Thoma-D/UCD/README.md

**MuziSym**

Het interactieve spel dat cognitieve, sensorische en motorische elementen combineert op een muzikale, toegankelijke en gebruiksvriendelijke manier. Dit zonder begeleider en op een zelfstandige manier

Projectteam: Thoma Demets en Cieters Jeroen

2024-2025
<p align="center">
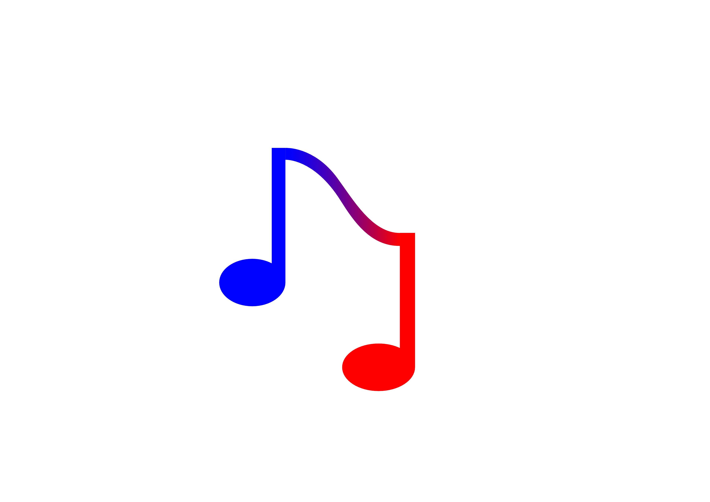
[picture p1: afbeeldingen/logo.png]


## Samenvatting
### Theoretisch
RGM: een interactieve en multisensorische oefenmethode die motorische, sensorische en cognitieve elementen bevat. Daarbij omvat:

- Het sensorische gedeelte: het waarnemen van de muziek en symbolen
- Het motorische gedeelte: het uitvoeren van de danspassen zoals in de rechterkolom
- Het cognitieve gedeelte: interpreteren van de symbolen en kleuren, deze linken aan de bijhorende danspas en deze juist coördineren.

Hierbij wordt er gebruik gemaakt van **symbolen en muziek**. Op deze muziek en symbolen worden danspassen uitgevoerd. Het combineren van deze elementen stimuleert de hersenen. 
Daarbij worden **dezelfde hersengebieden als bij het leren van een muziekinstrument geprikkeld**. “RGM therefore has the potential to activate the same brain areas as when learning how to play an instrument, although no instruments are involved.”[1]. Concreet resulteert deze methode in een hogere denksnelheid, kortere reactietijd, een betere coördinatie[2]. De theoretische werking wordt verder besproken in de inleiding.

### Spelverloop
Het initiële doel van dit spel is om de vier cilinders in de juiste volgorde te ordenen. Elk van deze cilinders wordt bij aanvang gekoppeld aan een deel (1/4de) van het gekozen muzieknummer. Bij het vastnemen van 1 cilinder begint het gekoppelde deel van de muziek te spelen en verschijnen op het schermpje de bijhorende danspassen. De mogelijke combinaties zijn in onderstaande figuur weergegeven. Nadat dit deeltje is afgespeeld, wordt een tweede cilinder vastgenomen. Het hierbij horende muziekje en danspasjes worden afgespeeld. Vanaf nu kan gekozen worden deze van plaats te verwisselen of nog een derde vast te nemen. Het spel gaat zo verder totdat de blokken in de juiste volgorde staan.
<p align="center">
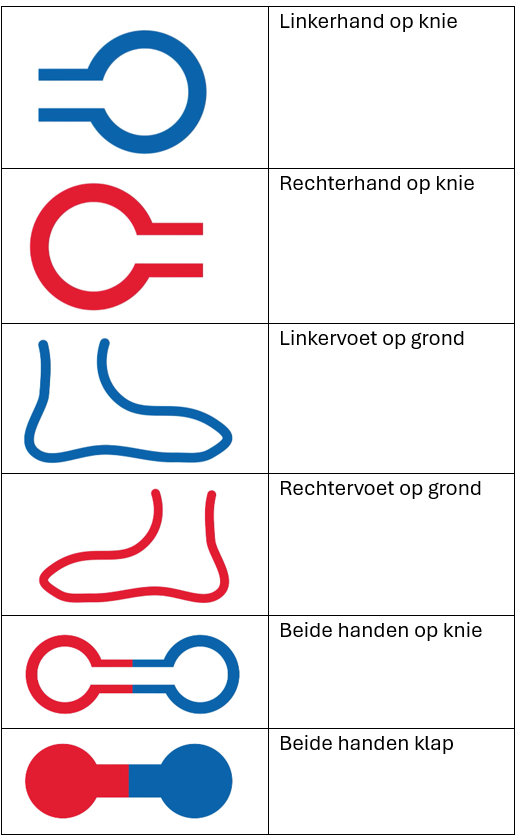
[picture p2: afbeeldingen/symbolen met uitleg.png]

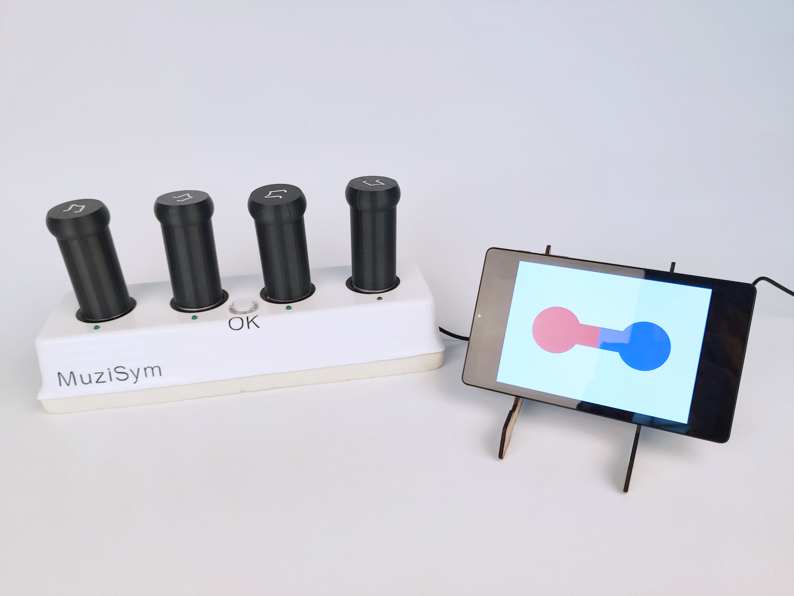
[picture p3: afbeeldingen/eind1.png]


## Introductie
### Theoretisch
Vooraleer het uitgebreider te hebben over het probleem is het eerst noodzakelijk dieper in te gaan op de theoretische werking van deze methode. Dit is noodzakelijk als achtergrond en aangezien het vervolg van dit proces steunt op dit principe.

Zoals eerder vermeld is dit een multi-sensorische denkoefening die gebruik maakt van zowel sensorische, motorische als cognitieve elementen bevat. **Het is net die combinatie van deze elementen die ervoor zorgt dat verschillende hersengebieden tegelijkertijd werken en geactiveerd worden. Het prikkelen van deze gebieden stimuleert deze hersengebieden en de verbindingen daartussen.** Daarbij is vooral het **belang van muziek niet te onderschatten.** Zo volgde uit een wetenschappelijk artikel: “In addition, musical activities induce grey and white matter changes in multiple brain regions, especially in front temporal areas”. Music also activates the dopaminergic mesolimbic system of the brain, which regulates memory, attention, executive function, mood, and motivation”[1]. Hierbij is het de bedoeling de het verkleinen van de cognitieve reserve tegen te gaan zoals uitgebreider besproken wordt in dit artikel van vrt-nws[3]

### Probleem
**Hoewel deze methode wetenschappelijk is aangetoond, staat deze methode praktisch echter nog in haar kinderschoenen.** In rusthuizen wordt slechts gebruikgemaakt van een beeldscherm [4] en [5], mensen en dan vooral ouderen thuis vallen helemaal uit de boot aangezien er in die methode een begeleider nodig is.

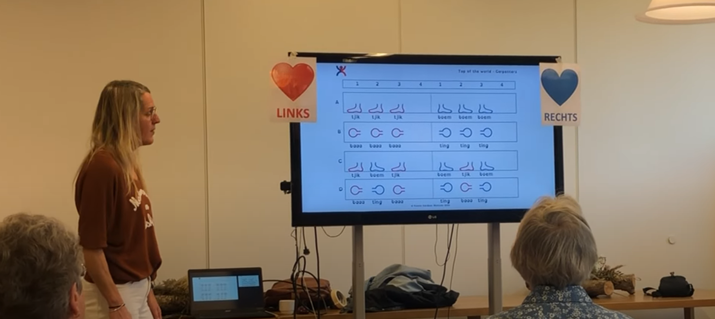
[picture p4: afbeeldingen/primitieve methode.png]


Het is deze grote “**gap**” die wij voor “65+ers zonder neurologische aandoening” op een gebruik(er)sgerichte en methodologische manier trachten op te lossen. Daarbij willen we de uitvoering van deze methode in een nieuw jasje steken zonder veel aan de theoretische werking te sleutelen.
### How might we
Hieruit volgt onze challenge, onze how might we:
**Hoe kunnen we 65 + ers zonder een neurologische aandoening preventief helpen bij het tegengaan van mentale veroudering door op een interactieve manier muziek, beweging, denken en waarnemen te integreren?**
### Stakeholders
De belangrijkste stakeholders in dit project zijn de testpersonen die de ook de eindgebruikers zijn. Wij danken hun zeer voor hun waardevolle imput. De medestudenten in de Krook voor hun andere blik en feedback op dit ontwerpproces
## Methodologie
Om een ontwerpproces tot een goed eind te brengen is het belangrijk methodologisch te werk te gaan en een goeie methodologie te gebruiken. Centraal in dit project wordtgebruik gemaakt van Zendesk triple diamond zoals in onderstaande figuur. Daarnaast wordt vanuit de piramide van Aaron Walter vertrokken. Daarbij wordt onderaan gestart om op uiteindelijk bij pleasurable uit te komen
<p align="center">
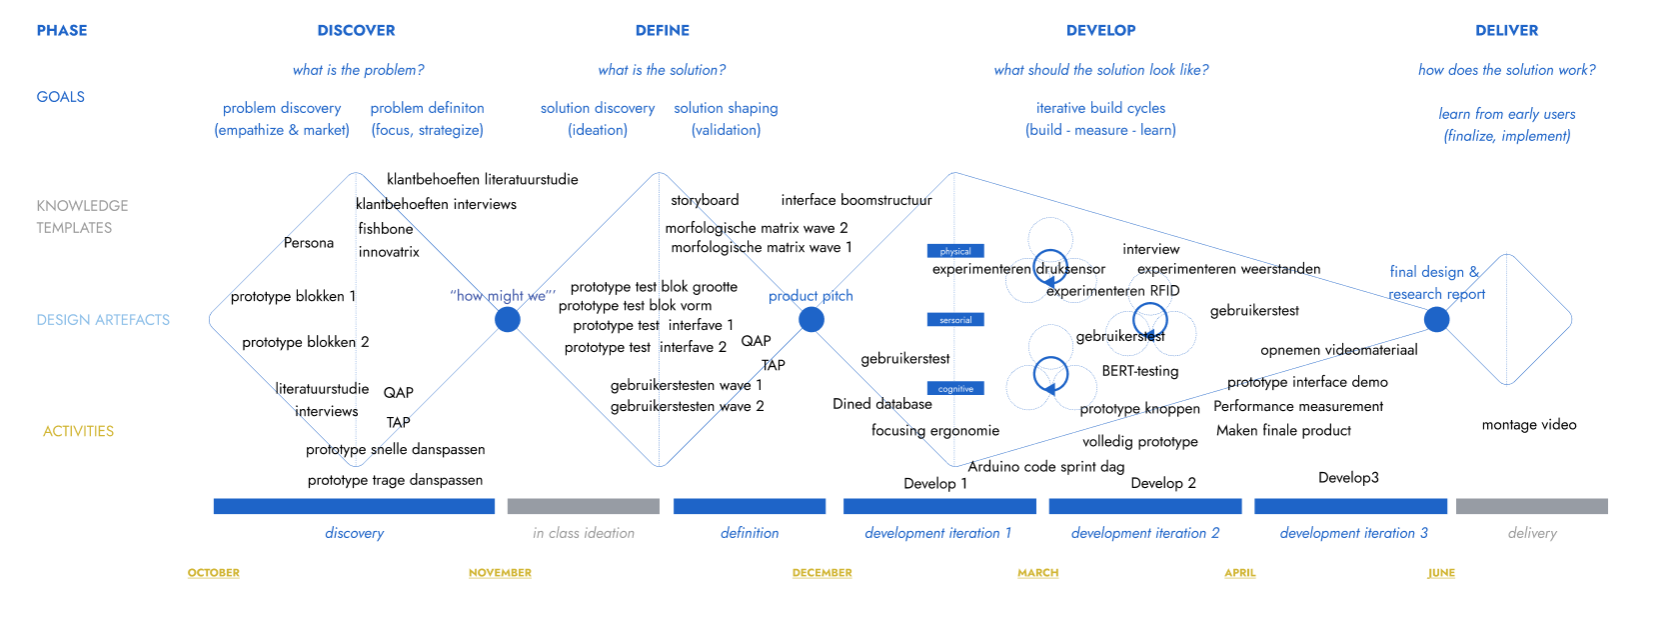
[picture p5: afbeeldingen/zendesk.png]

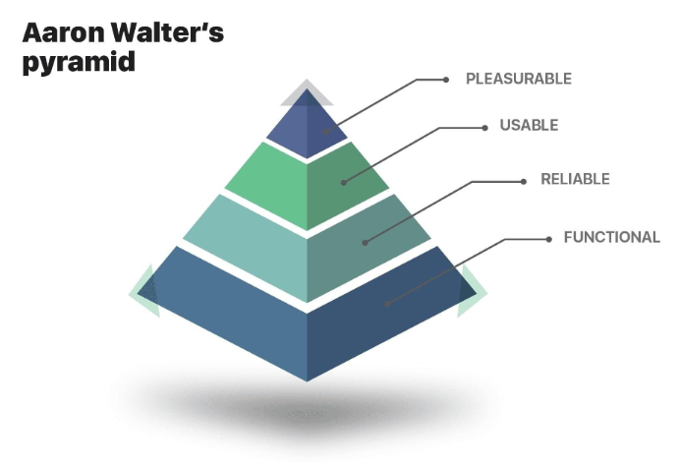
[picture p6: afbeeldingen/Aaron Walter.png]

 
### Discovery fase
Binnen deze triple diamond is de discoveryfase de eerste fase. Zoals de naam het zelf zegt is het hierbij de bedoeling een goed en volledig beeld te krijgen inzake de RGM methode. Daarbij is het belangrijkste doel om vragen als: **Waar liggen de Gaps? Hoe werkt deze methode? Wie is de geschikte doelgroep?** Te beantwoorden
Daarbij vormt de **combinatie van een literatuurstudie en interviews een goede basis**. 

### Definition fase

Binnen de definition wordt-binnen de overkoepelende Zendesk triple diamond methodologie-onze eigen methode gebruikt zoals hieronder weergegeven.
<p align="center">


Eerst wordt een storyboard opgesteld dat elke stap van het gebruiksproces benaderd. Hieruit werden mogelijke onderzoeksvragen opgesteld. Een deel van deze vragen kon al met de voorkennis van de literatuurstudie in interviews beantwoord worden. De overgebleven onderzoeksvragen onderzochten we in de gebruikerstesten. 

In deze fase wordt nu dat de fundamentele kennis er is gekeken naar de functionele parameters van het concept. Vragen als **hoeveel blokken? Welke vorm hebben de blokken? En hoe snel volgen de danspassen op elkaar?** worden beantwoord.

### Develop fase
Hierbij ligt de nadruk meer op detaillering en validering van prototypes.
In **develop 1** wordt nog gefocust op de ergonomie. 
In **develop 2** wordt nog even teruggekomen op de ergonomie. Voornamelijk wordt hierbij op de integratie van de elektronica gefocust. Hieronder vallen zowel het mechanisme van de verbinding van de cilinder met het dockingstation als het type en grootte van de knop. In **develop 3** wordt uiteindelijk het volledige spel nog eens gespeeld waarbij alle stappen nog eens gevalideerd en mogelijk verbeterd worden.

### Deliver fase 
Belangrijk: deze fase is eerder overlappend en minder chronologisch!

Uit voorgaande prototypes, gebruikerstesten, templates, experimenten (zie o.a. prototyping - elektronica) wordt een finaal prototype/product uitgewerkt. Met behulp van DaVinci Resolve en beeldmateriaal uit voorgaande testen wordt ook een video gerealiseerd. Deze geeft het ontwerpproces en het product weer.

## Discovery

#### Doelstellingen
- Formuleren van een duidelijke "How might we"-vraag om richting te geven aan het ontwerpproces
- Opstellen klantbehoeften
- Algemeen beeld inzake RGM en beantwoorden onderzoeksvragen
#### Onderzoeksvragen  
literatuurstudie
- Wat is de RGM methode?
- Secundaire onderzoeksvragen:
- Hoe helpt de RGM methode mensen? 
- Hoe werkt deze methode? 
- voor wie is deze methode het meest geschikt? 
- is de doelgroep groot? 
- Welke rol speelt muziek?  
- Hoe werkt dit in de hersenen? Welke hersengebied bevindt zich waar? 
- Hoe veroudert ons lichaam? 

interviews
- Hoe staan 65+ ers zonder neurologische aandoening tegenover de RGM-methode?
- Welke aspecten van deze methode spreken hen aan? 
- Wat zien ze liever anders?  
#### Materiaal & methoden
* Literatuurstudie 
* Interviews 
* Benchmarking

### Resultaten literatuurstudie (N=10)
- [protocol](https://github.com/Thoma-D/UCD/blob/main/Bijlages/Discovery/protocol%20literatuurstudie.pdf)
- [rapport](https://github.com/Thoma-D/UCD/blob/main/Bijlages/Discovery/literatuurstudie%20gebruiksgericht.pdf)

Om een goed beeld te vatten van de RGM-methode en alle opportuniteiten er rond, wordt begonnen met een literatuurstudie. Hierbij werden zowel wetenschappelijke artikels, websites, databases en gewone artikels bestudeerd om met een solide basis te beginnen.

**De belangrijkste bevindingen - die onder andere de onderzoeksvragen beantwoorden - worden hieronder weergegeven**:

1. Als doelgroep wordt “65+ers zonder neurologische aandoening” gekozen. Geen kinderen omdat deze methode minder efficiënt en invloed heeft op hun hersenen. 65+ers omdat dit een groot deel van de bevolking is. Zo blijkt uit Statbel dat **18,9% van de Vlamingen 65+er** is.
<p align="center">
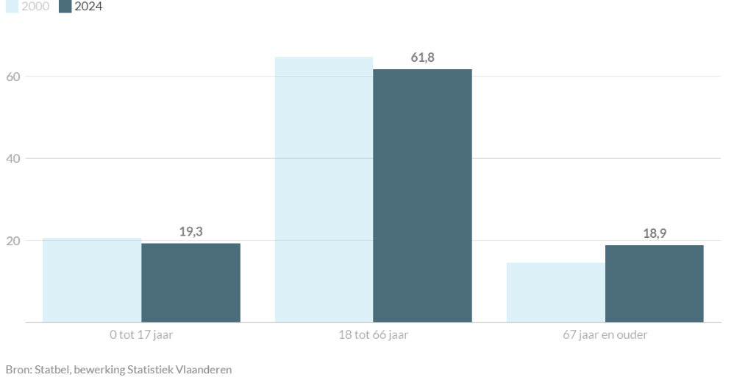
[picture p7: afbeeldingen/bevolking Vlaanderen.png]


2. De hedendaagse methode vereist een scherm, practionner en een groepsgebeuren zoals hieronder te zien. **Een belangrijke gap is dat er dus geen kant en klare thuis oplossing bestaat dat de eindgebruiker autonoom kan gebruiken.**
<p align="center">


3. **Door de sterke achterliggende theorie van RGM zoals hierboven vermeld is het nuttig de theoretische werking( combinatie muziek, symbolen en danspassen) over te nemen en in een nieuw jasje te steken. Het is de bedoeling de theoretische werking te integreren in een eindproduct.**

4. In dit [1] wetenschappelijk artikel wordt de methode theoretisch samengevat: “In addition, musical activities induce grey and white matter changes in multiple brain regions, especially in front temporal areas [3]. Music also activates the dopaminergic mesolimbic system of the brain, which regulates memory, attention, executive function, mood, and motivation.” Wat verder wordt gezegd: “RGM therefore has the potential to activate the same brain areas as when learning how to play an instrument, although no instruments are involved.” **Muziek speelt dus een heel belangrijke rol.**

5. Uit dit [6] wetenschappelijk artikel volgt dat de mens verouderd doordat dit in ons DNA zit en door chemische reacties versterkt door UV straling. In functie van deze oorzaken kan binnen onze haalbaarheid niet worden ontworpen. wel kunnen bovenstaande voordelen blijven wanneer de theoretische werking van RGM verder geintegreerd wordt tot een product.
Hieruit volgt onderstaand fishbone diagram.
<p align="center">
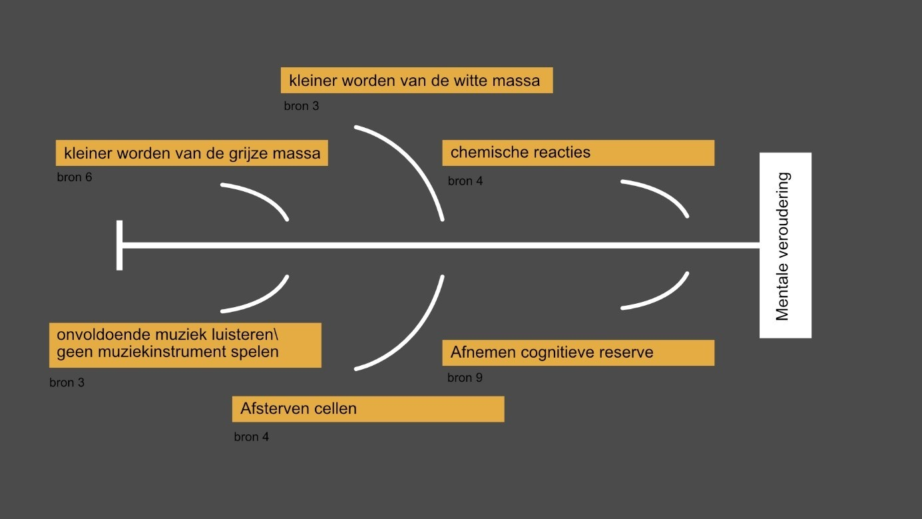
[picture p8: afbeeldingen/fishbone diagram.jpg]
 

> [!IMPORTANT]
> Design Requirements:
> - D1.1 Het product moet meerdere hersengebieden activeren	
> - D1.2 Het product moet in groep te kunnen gebruiken zijn	
> - D1.3 Het product moet fouten maken toelaten
> - D1.4 Het product moet muziek bevatten	
> - D1.5 Het product moet ritme bevatten	
> - D1.6 Het product moet de ervaring geven/ er in slagen dat de doelgroep er steeds beter in wordt

### Interviews (N=4)
- [protocol](https://github.com/Thoma-D/UCD/blob/main/Bijlages/Discovery/protocol%20interview.pdf)
- [rapport](https://github.com/Thoma-D/UCD/blob/main/Bijlages/Discovery/interview%20verslag.pdf)

Het is ook belangrijk rechtstreekse input van de gebruiker te krijgen en deze beter te leren kennen dan deze zichzelf kent. Door middel van interviews kan op deze manier direct bekeken worden wat de gebruiker zelf vindt. **Zo kan in een wetenschappelijk artikel staan dat muziek positieve effecten heeft, maar dat de gebruiker hier niet voor muziek open staat.** Om dit te vermijden werden vier proefpersonen die binnen de doelgroep “65+ers zonder neurologische aandoening” vallen geïnterviewd.

Wanneer ze gevraagd worden naar de originele methode te kijken, blijkt dat: 

1. > “Het ziet er zo moeilijk uit al deze dingen tegelijkertijd te doen”.

    Hiermee geeft Marleen Hofman aan dat ze de combinatie van motorische, sensorische en cognitieve prikkels te veel vindt." De danspassen die in de rest van dit project noodzakelijk zijn zullen dus trager op elkaar aansluiten.

2. > “Ik hoop hiermee mijn grenzen te verleggen. Achteraf hoop ik te kunnen zeggen: amai ik had nooit gedacht dat ik dit zou kunnen”.

    Hiermee geeft Joske aan wat ze met dit spel zou willen bereiken. Daaruit blijkt dat de gebruiker open staat voor het concept.

3. Als naar hun gevoelens op de **gevoelsroos van Plutchik** gevraagd wordt komen vooral de gevoelens: angst en nieuwsgierigheid op.

4. Na het afnemen van de interviews kan bovenstaande informatie samengevat worden in onderstaande persona. Dit is belangrijk in het vervolg van het proces zodat telkens gebruiksgericht ontworpen wordt.
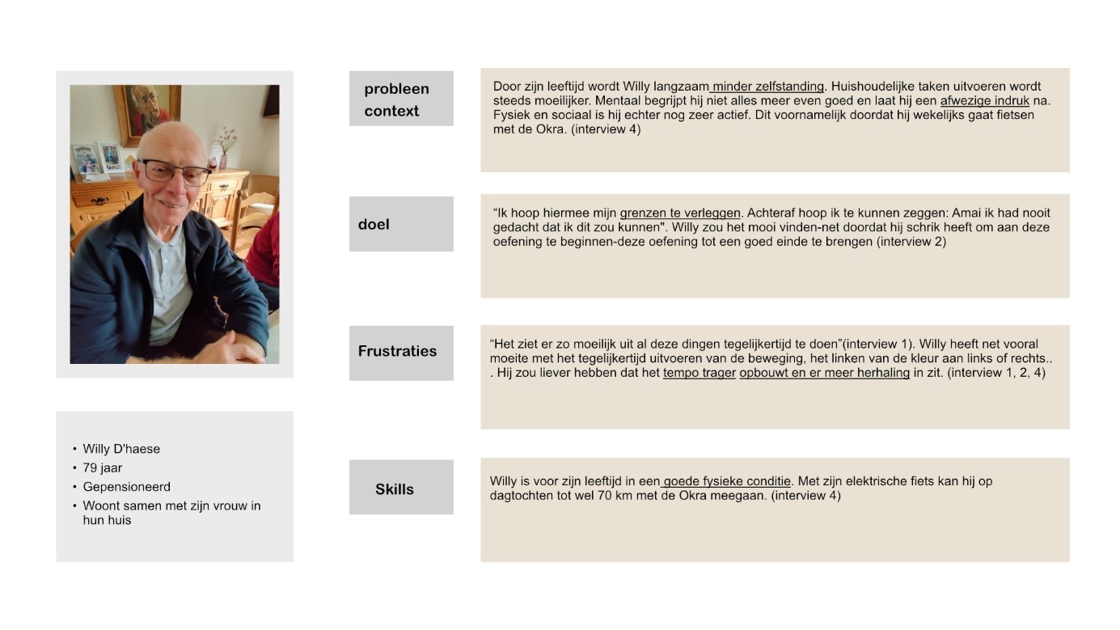
[picture p9: afbeeldingen/Persona.jpg]


> [!IMPORTANT]
> Design Requirements:
> - D1.7 Het product moet verschillende moeilijkheid niveaus bevatten	
> - D1.8 Een sessie moet geleidelijk opbouwen	
> - D1.9 De muziek moet instelbaar of gekend zijn	
> - D1.10 Het product moet thuis te gebruiken zijn	
> - D1.11 Het product moet voor zowel individuele (eenzame) als meerdere personen tegelijkertijd geschikt zijn 	
> - D1.12 Het product moet een alternatief voor dans kunnen bevatten	
> - D1.13 Het product moet buiten te gebruiken kunnen zijn 	
> - D1.14 Het product moet zo weinig mogelijk schermen, verbinding met smartphones en tablets bevatten	

### Benchmarking (N=11)
- [protocol](https://github.com/Thoma-D/UCD/blob/main/Bijlages/Discovery/ProtocoL_Benchmarking_Thoma_Demets.pdf)
- [rapport](https://github.com/Thoma-D/UCD/blob/main/Bijlages/Discovery/Studie_Benchmarking_Thoma_Demets.pdf)

Aan de hand van Benchmarking werd de huidige markt en hun huidige oplossingen geanalyseerd. Deze worden in onderstaande tabel op basis van een analyse, specificaties... weergegeven.
<p align="center">
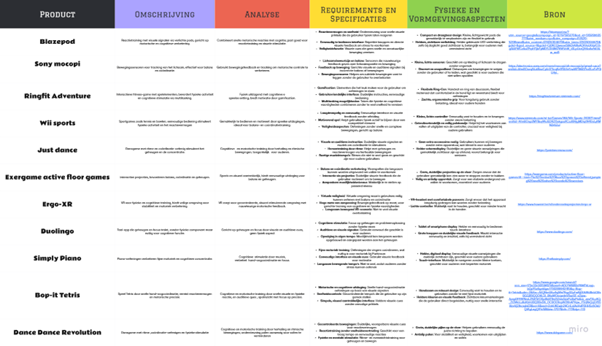
[picture p10: afbeeldingen/Benchmark analyse.png]


Momenteel passen geen producten RGM rechtstreeks toe. Daarom werden hierbij gelijkaardige, relevante en succesvolle producten geanalyseerd om zo tot extra design requirements te komen. Uiteindelijk werd met deze data volgende tabel opgesteld. 

### Conclusies & implicaties
De analyse vanuit literatuurstudie, interviews en benchmarking heeft geleid tot een duidelijk beeld van de doelgroep, “65+’ers zonder neurologische aandoening,” en hun behoeften. **De doelgroep staat open voor de RGM-methode, maar vraagt om een rustiger tempo, meer herhaling en verschillende moeilijkheidsniveaus.** Daarnaast is er een sterke voorkeur voor een gebruiksvriendelijke thuisoplossing die zelfstandig kan worden gebruikt. **Benchmarking toont aan dat er momenteel geen directe RGM-producten op de markt zijn, maar vergelijkbare oplossingen bieden waardevolle inzichten voor het ontwerp en bevestigen de bestaande marktkans.** In onderstaande innovatrix kan bovenstaande informatie nog een samengevat worden.
<p align="center">
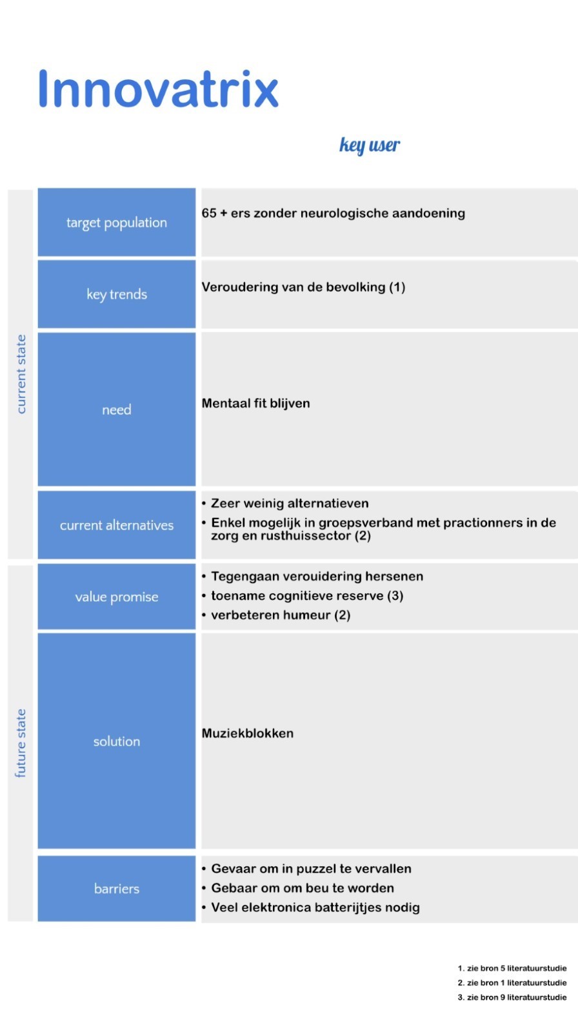
[picture p11: afbeeldingen/Innovatrix.jpg]


Uiteindelijk volgt de how might we:

**Hoe kunnen we 65 + ers zonder een neurologische aandoening preventief helpen bij het tegengaan van mentale veroudering door op een interactieve manier muziek, beweging, denken en waarnemen te integreren?**

## Definition
<p align="center">
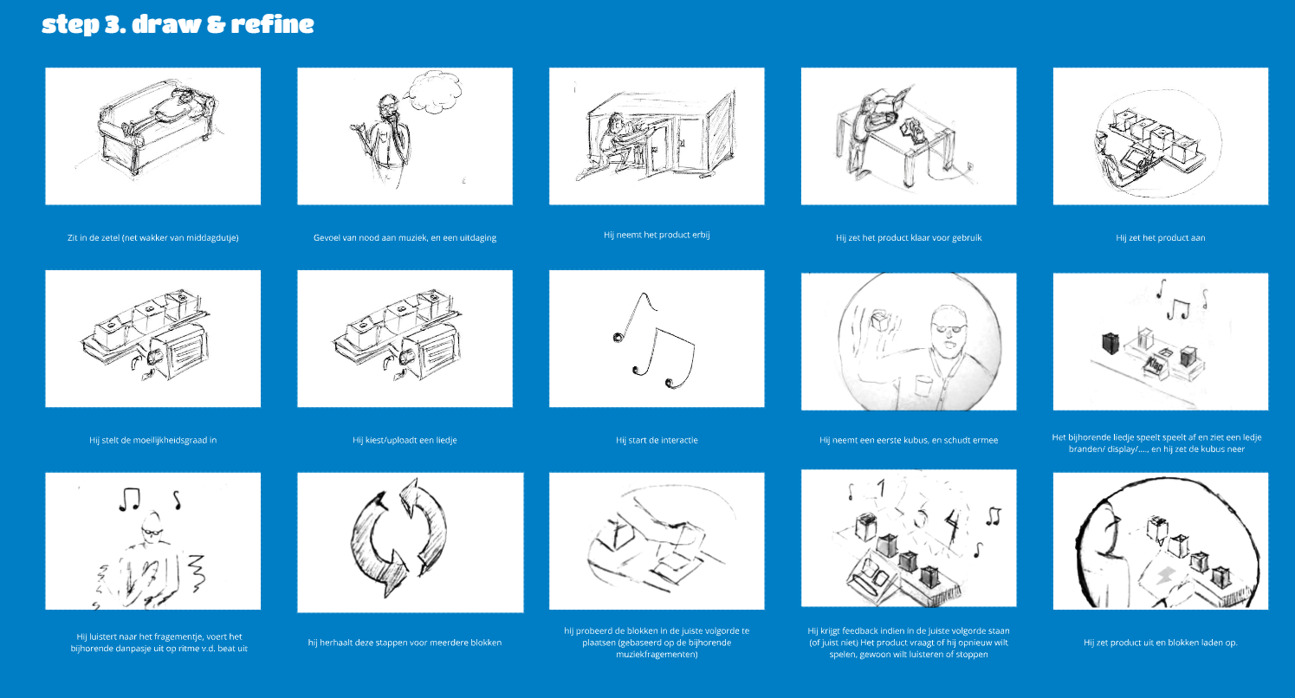
[picture p12: afbeeldingen/Storyboard.png]

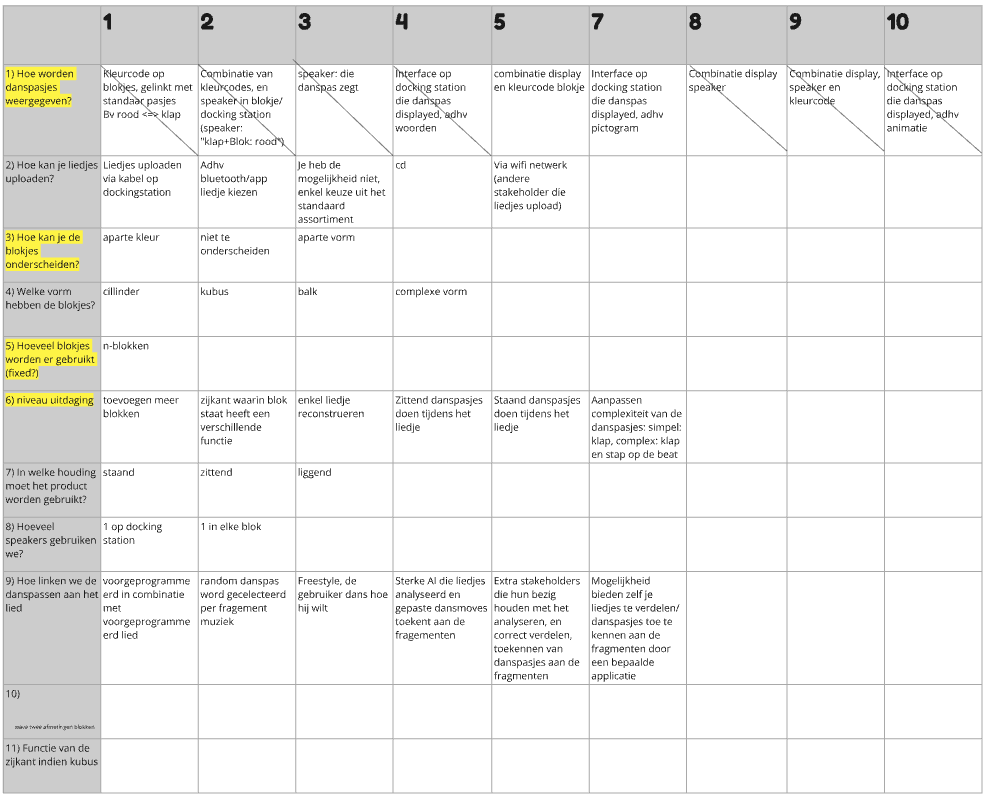
[picture p13: afbeeldingen/Wave 1 morfologische matrix.png]

</p>

In deze wave wordt vooral op de functionele aspecten gefocust. Dit a.d.h.v.de aspecten uit bovenstaand storyboard.
**Om confirmation bias te vermijden en ervoor te zorgen dat de gebruiker nuttige feedback kan geven, werd telkens van meerdere prototypes gebruik gemaakt**. Hierdoor zijn er op de afbeeldingen van prototypes meestal twee varianten te zien. 

Zoals in de methodologie beschreven werd een deel van de onderzoeksvragen al in bovenstaande matrix beantwoord. Diegene die overbleven zijn de onderzoeksvragen van deze wave. Voor de tweede wave wordt dit opniew gedaan.

### Resultaten WAVE 1 (N=5)
- [protocol](https://github.com/Thoma-D/UCD/blob/main/Bijlages/Definition/protocol%20gebruikerstest%20wave%201.pdf)
- [rapport](https://github.com/Thoma-D/UCD/blob/main/Bijlages/Definition/gebruikerstest%20wave%20one.pdf)
#### Doestellingen
- Bepalen hoe de danspassen weergeven worden
- Bepalen als de blokken te onderscheiden moeten zijn
- Bepalen van het aantal blokken
#### onderzoeksvragen
In deze fase zijn de aspecten uit het storyboard van wave 1 de onderzoeksvragen zoals:
- Hoeveel blokken worden gebruikt?
- welke vorm hebben de blokken?
- Hoe snel volgen de danspassen elkaar op
- Hoe worden de danspassen weergegeven
#### Materiaal & methoden
- Smartphone
- Video's RGM danspassen
- 6 indentiek gekleurde blokken
- 4 verschillend gekleurde blokken
- interview met:
  - TAP (think out lout protocol)
  - QAP (Question asking protocol)

<p align="center">
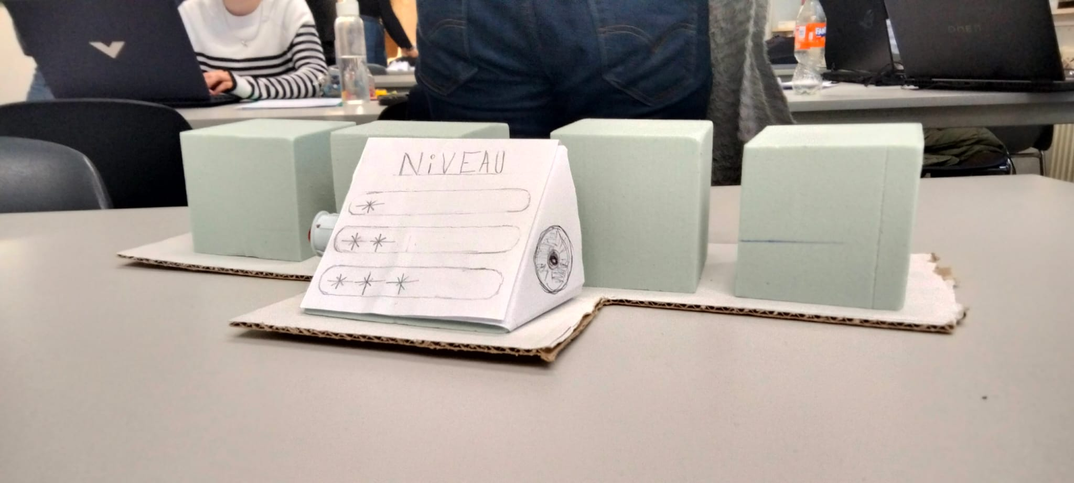
[picture p14: afbeeldingen/Prototype 1 (2).jpg]
  
</p>

#### aspect 1: Weergave danspassen 

Voor de eerste wave werden vooraf 3 variaties van videofragmenten van “Laat de zon in je hart” met RGM-symbolen voorbereid. Waarbij een verandering van danspas werd weergegeven aan de hand van een korte overgansanimatie. 

* 1: Frequentie danspassen: om de 4 slagen

  Lied verdeeld in: 4
  [Links naar video's](https://github.com/Thoma-D/UCD/blob/main/Bijlages/Definition/Videofragmenten/Traag%204/Trage%20video's)

* 2: Frequentie danspassen: om de 2 slagen

  Lied verdeeld in: 4
  [Links naar video's](https://github.com/Thoma-D/UCD/blob/main/Bijlages/Definition/Videofragmenten/snel%204/snelle%20video's%20(in%204))

* 3: Frequentie danspassen: om de 2 slagen

   Lied verdeeld in: 6
  [Links naar video's](https://github.com/Thoma-D/UCD/blob/main/Bijlages/Definition/Videofragmenten/snel%206/snelle%20video's%20(in%206))

60% van de gebruikers verkoos de trage versie. Aangezien deze cijfers verdeeld zijn, is het het best hen de keuze te geven. 

#### aspect 2: Onderscheid blokken

Om dit te testen werd eenmaal 4 blokken met dezelfde kleuren voorzien en eenmaal met verschillende kleuren.
<p align="center">
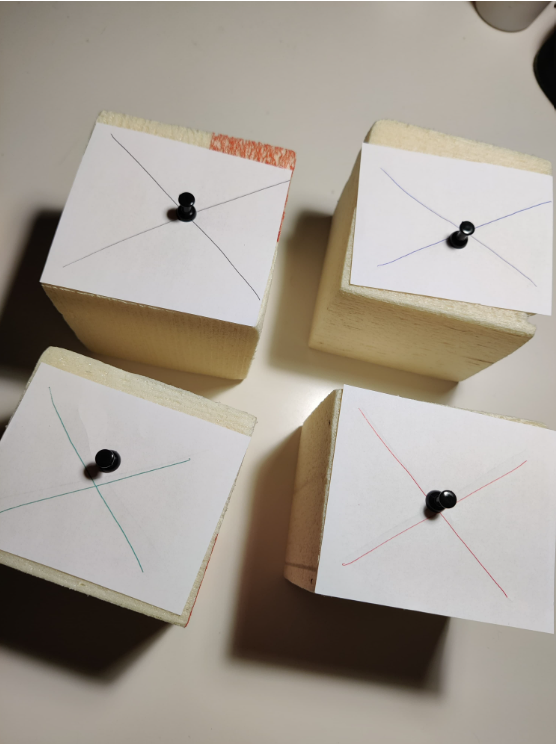
[picture p15: afbeeldingen/blokkenverschillendekleur.png]
  
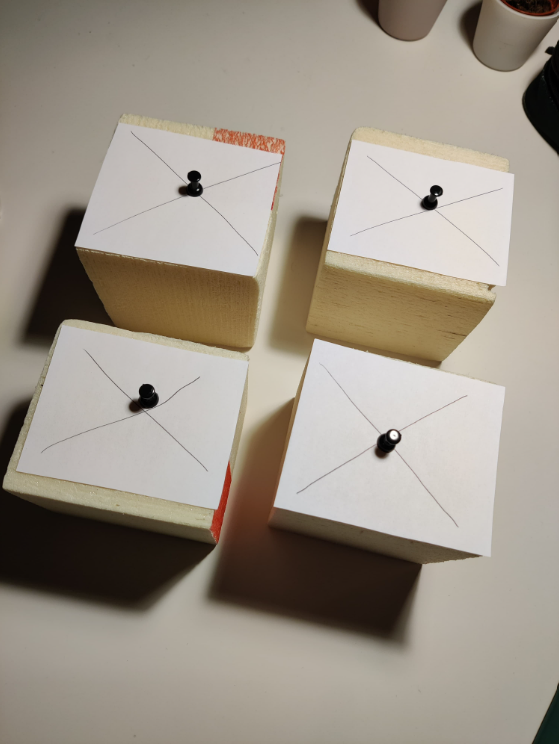
[picture p16: afbeeldingen/blokkenzelfdekleur.png]
  
</p>

Uit observatie en het QAP, konden we concluderen dat 60% (3/5) verkoos ze te kunnen onderscheiden. 

<p align="center">
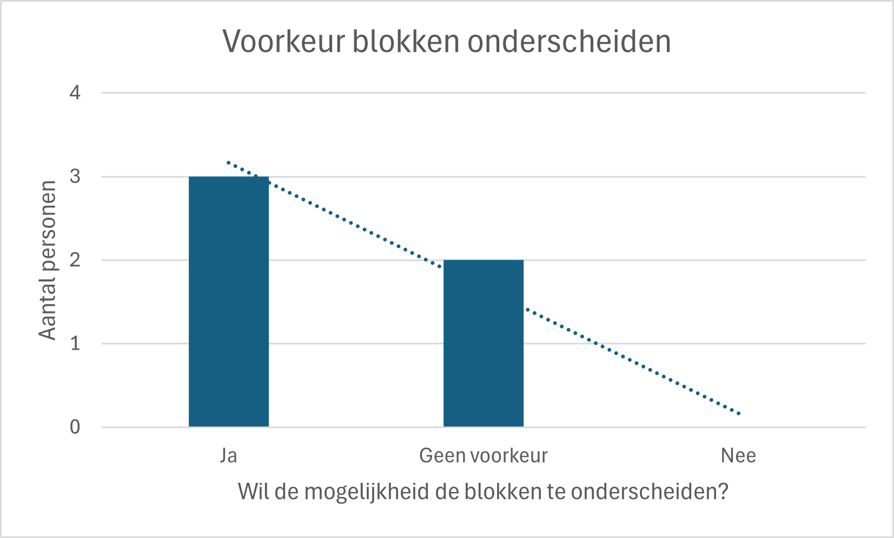
[picture p17: afbeeldingen/Grafiek Blokken onderscheiden.png]
 
 </p>

Uiteindelijk werd hieruit ook bepaald om de vorm van de blokken cilindrisch te maken om zo 2 functionele zijdes te creeren. Die nodig zijn om een kleur en effen zijde te creëren. Een cilinder is de enigste vorm die dit op een ergonomische manier toelaat. Dit leidde dan tot design requirements D2.3 en D2.2.

#### aspect 3: Aantal blokken

Na het spel met eenmaal 4 en eenmaal zes blokken gespeeld te hebben verkoos 80% de variant met 4 blokken. Ook gaf de gebruiker dit zelf aan:
> “Het is lastig om zowel op de danspassen als de muziek te letten” 

 Hieruit volgt de design requirement D.2.1

<p align="center">
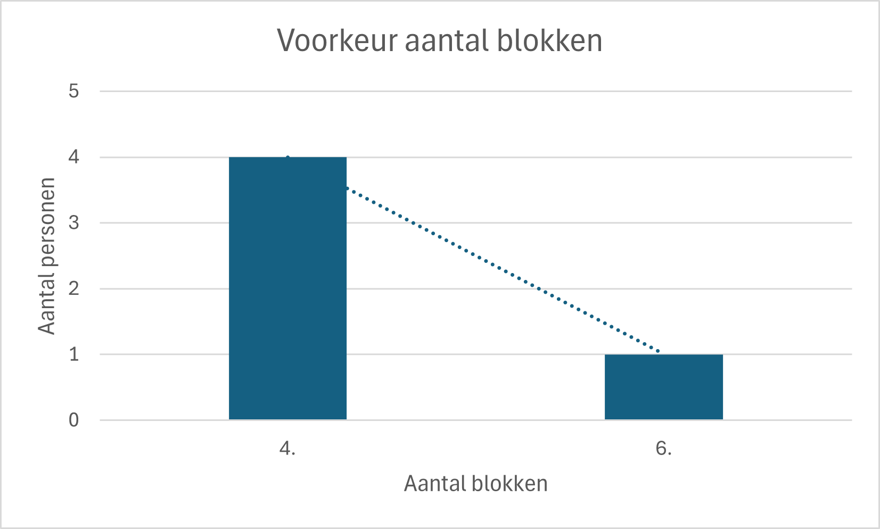
[picture p18: afbeeldingen/Grafiek aantal blokken.png]
 
 </p> 
 Wat opviel is dat de grootste moeilijk lag bij het sorteren van de blokken. 60% van de gebruikers vroeg, of vermelde dat ze graag het de mogelijkheid zouden hebben een nummer op voorhand eens te beluisteren. Vandaar design requirement D1.15. Bij de kleuren en hun bijhorende kanten werden ook veel fouten gemaakt, daaruit volgt design requirement D 4.4.
 
### Conclusies

Hieronder volgen nog enkele losstaande conclusies: 
1. Het product laat de gebruiker het liedje op voorhand horen als dit gewenst is.
2. Het product bestaat uit 4 interactieve cilindervormige blokken met 2 fuctionele zijdes.
3. Er zit 1 centrale speaker in de docking station, zo houden we de kostprijs lager en kunnen we de cilinders compacter houden.
4. De grootste moeilijkheid zit hem in het in de juiste volgorde van de cilinders plaatsen. Niet in het uitvoeren van de danspassen.
5. > “Welke kant is rood”

    De gebruiker linkt rood aan rechts. Dit doordat dit zo bij hun hoorapparaat ook zo het geval is. 

> [!IMPORTANT]
> Design Requirements:
> - D1.15 Het product moet de mogelijkheid geven het muzieknummer vooraf volledig te spelen
> - D2.1 Het product moet vier interactieve blokken bevatten	* Het product moet verschillende moeilijkheidsgraden hebben
> - D4.4 Het product moet duidelijk aangeven wat rechts(rood) en wat links(blauw) is
> - D2.3 De interactieve blokken zijn cilindervormig, om duidelijk 2 verschillende kanten te hebben, met elk zijn unieke functie
> - D2.2 	De interactieve blokken moeten zowel een te onderscheiden als een niet te onderscheiden kant hebben (1kant allemaal dezelfde kleur, 1 kant allemaal een verschillend kleur)
> - D4.3 De docking station van het product moet een speaker bevatten	

### WAVE 2 (N=5)
- [protocol](https://github.com/Thoma-D/UCD/blob/main/Bijlages/Definition/protocol%20interview%20wave%202.pdf)
- [rapport](https://github.com/Thoma-D/UCD/blob/main/Bijlages/Definition/gebruikerstest%20wave%20two.pdf)

In de tweede wave wordt meer op de details gefocust. Hieronder vallen geometrie, kleur en interface. De uitgebreide methodologie wordt onder "methodologie besproken".



### Doestellingen
- Bepalen geometrie en displaygrootte
- Bepalen interface
- Hoe staan ouderen t.o.v. belonigsystemen

### Onderzoeksvragen
In deze fase zijn de aspecten uit het storyboard van wave 1 de onderzoeksvragen zoals:
- Welke displaygrootte?
- Welke afmetingen cilinder?
- Waar moet aandacht aan worden besteed bij de interface

### Materiaal & methoden
- Figma interface met woorden en interface met symbolen
- Smartphone (6.7")
- Tablet (10.9")
- Laptop (15.6")
- tv
- Interview
- BERT-test

De gebruikerstesten worden uitgevoerd als een combinatie van BERT-testen en interviews. **De BERT-testen zorgen voor kwantitatieve informatie. De interviews voor meer kwalitatieve info.**
  
### Resultaten

#### Aspect 1: Displaygrootte

Daarvoor werden tijdens de interviews gebruik gemaakt van een smartphone, tablet, een laptop en een TV. Zoals op onderstaande figuur te zien is.  

<p align="center">
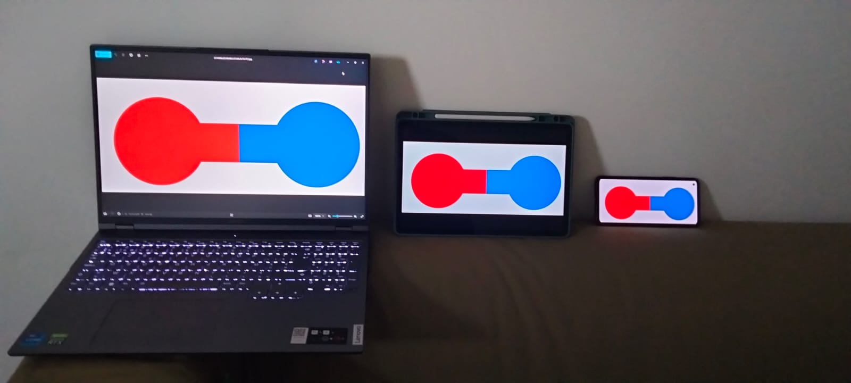
[picture p19: afbeeldingen/Schermgroottes.png.jpg]

 </p> 

Hierop reageerden de gebruikers verdeeld. 40% koos voor het 6.7" scherm, 40% tv en 20% 10.9" scherm zoals in onderstaande grafiek te zien is. Daarbij valt op dat de trendlijn daalt en links het hoogst ligt aangezien daar de meeste waarden liggen.

<p align="center">
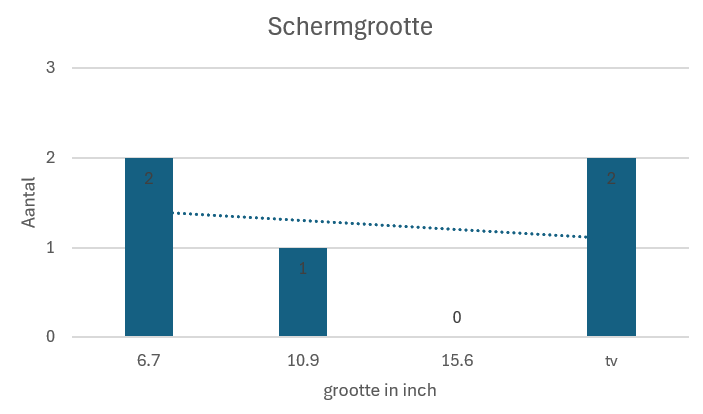
[picture p20: afbeeldingen/Schermgrootte.png]

 </p> 

Aangezien de doelgroep niet weet wat een HDMI- kabel is kan dit ook niet gekoppeld worden aan een tv-scherm. Hierdoor schieten de kleine schermen over.
>  “wat is een HDMI-kabel”.**  

#### Aspect 2: Afmetingen van de cilinders

Uit wave 1 was gebleken dat deze cilindervormig moeten zijn. A.d.h.v. drie groottes kan de gebruiker nu nauwkeuriger kiezen welke deze het meest aangenaams vindt. Uit de BERT testen en interviews blijkt dat 80% 45mm als diameter verkiest. Dit doordat deze het makkelijkst vast te pakken zijn.

<p align="center">
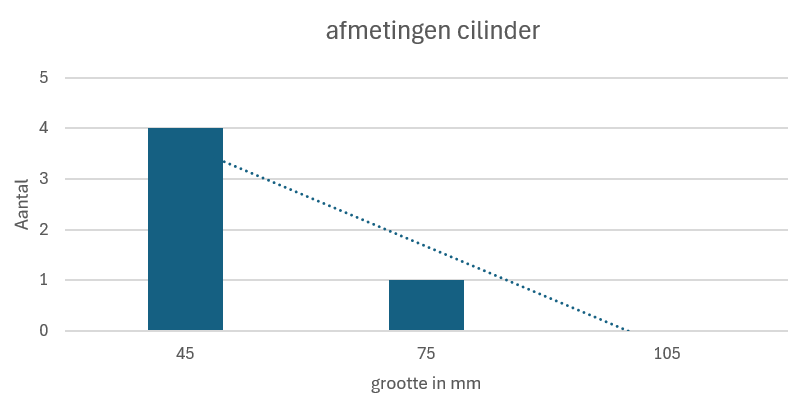
[picture p21: afbeeldingen/Afmetingen cilinder.png]

 </p> 

#### Aspect 3: Beloningssystemen

Ook binnen onze doelgroep worden de geïnterviewden wel degelijk geconfronteerd met dergelijke systemen. Vooral **klantenkaarten en klantenapps bij supermarkten blijken populair te zijn. Daarbij viel op dat hun voorkeur uitgaat naar een manuele kaart i.p.v. een app waar ze veel meer met dergelijke systemen geconfronteerd worden.** Uiteindelijk blijkt dat ze openstaan om hun vooruitgang te zien maar minder geïnteresseerd zijn in echte grote beloningssystemen. 

#### Aspect 4: Interface

Wanneer de gebruiker gevraagd wordt naar welk voorkeur de interface gaat, blijkt dat: Hoe simpeler de interface, hoe minder verwarring en vlotter de gebruiker hierdoor kan navigeren. Wat opviel, is dat de doelgroep veel **minder vertrouwt blijk te zijn met symbolen dan gewoon woorden**. Bijgevolg zal worden verder gewerkt met een interface a.d.h.v. woorden
Om de uitwerking van de interface in het vervolg van het proces vlotter te laten verlopen werd een boomdiagram van de interface gemaakt zoals in onderstaande figuur te zien is. De interfaces zijn onder "bijlagen" terug te vinden.

<p align="center">
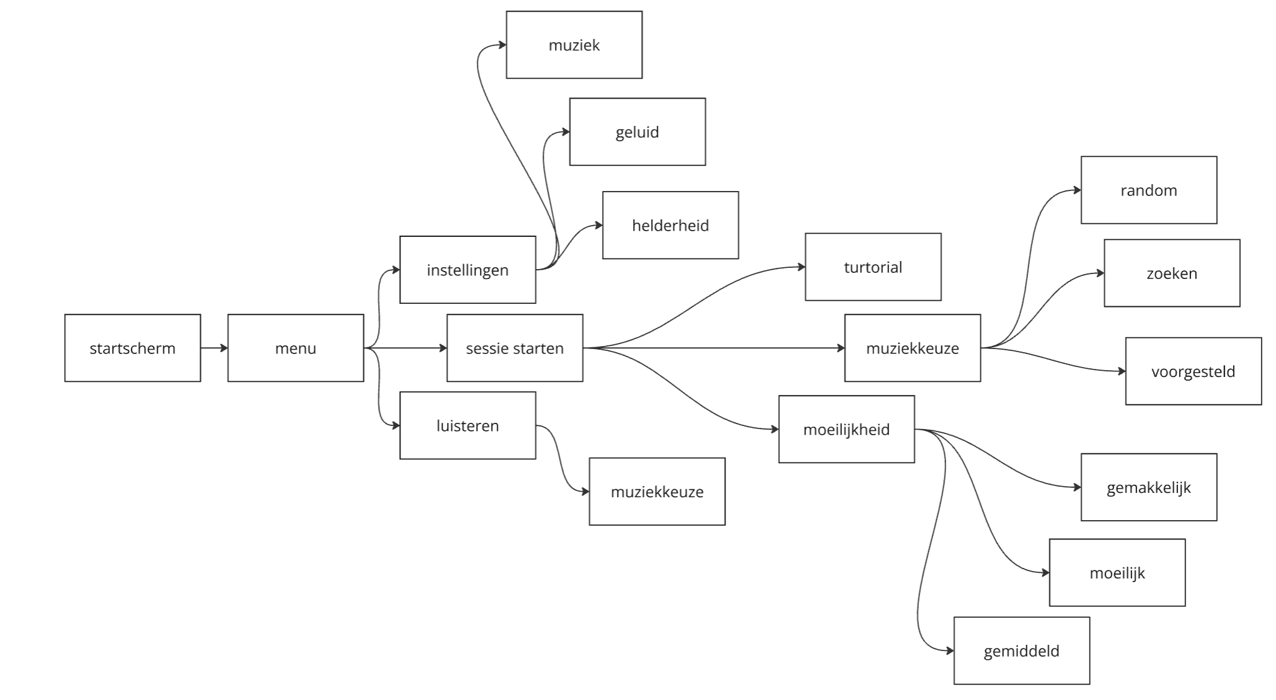
[picture p22: afbeeldingen/boomschema interface.png]

 </p>
 
### Conclusies
**Displaygrootte**

Naast het feit dat de cijfers verdeeld waren wordt voor een scherm tussen 6.7" en 10.9" gekozen. Dit om de kostprijs te drukken, om het sukkelen met HDMI poorten te vermijden (zie interview Willy: “wat is een HDMI-kabel”) en aangezien volgens de trendlijn daar de meeste waarden liggen.

**Cilindergrootte**

De cilinder heeft een diameter van 45 mm.

**Beloningsysteen**

Doelgroep wenst geen uitgebreid beloningssysteem.

**Interface**

De interface moet voldoende simpel zijn.
De interface steunt voornamelijk op woorden en niet op symbolen.

> [!IMPORTANT]
> Design Requirements:
> - D3.3 De schermgrootte ligt tussen 6.7" en 10.9"
> - D3.3 Onderstaande interface wordt gebruikt.
> - D2.4 De interactieve blokken hebben een hoogte en straal van 45mm
> - D1.17 De gebruiker heeft de mogelijkheid om zijn vooruitgang te zien
> - D3.1 en D3.2 De interface moet simpel zijn. Daarbij wordt voornamelijk van woorden gebruik gemaakt

## Develop
### Wave 1
- [protocol](https://github.com/Thoma-D/UCD/blob/main/Bijlages/Develop/develop1%20protocol.pdf)
- [rapport](https://github.com/Thoma-D/UCD/blob/main/Bijlages/Develop/develop%201%20rapport.pdf)
#### Doestellingen
1. Bepalen van de meest ergonomische massa.
 1a. a.d.h.v. gebruikerstest voor rechtstreekse input.

2. ergonomische afmetingen
  
    2a. Omtrek a.d.h.v. database gebruikt voor een grotere steekproef (werd eerder uit gebruikerstest bepaald)

    2b. Hoogte 

### Materiaal & methoden
- Ondoorzichtige cilinder (2X) 
- Anders niet tegelijkertijd 
- Weegschaal 
- Vloeistof( water) 

- Percentile driven design 
- Gebruikerstest  

- DINED-database 

#### Resultaten
**1: Meest ergonomisch gewicht**

Er werden 2 gewichten met een verschil van 100g aan de gebruiker voorgeschoteld, om deze door hen te laten vergelijken. 
Hieruit kiezen ze hun voorkeur, vervolgens wordt vanaf deze massa, met een kleiner verschil (50g, 25g) deze stap herhaald. Dit tot hun ideale massa is bepaald.

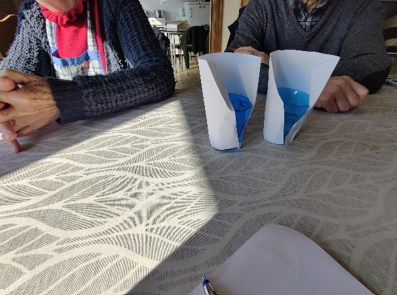
[picture p23: afbeeldingen/Gebruikerstest.png]
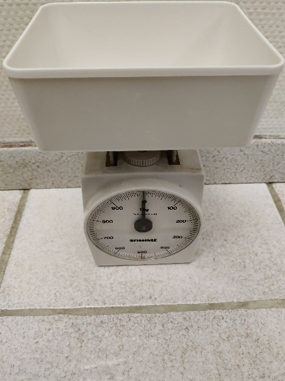
[picture p24: afbeeldingen/weegschaal.png]
 
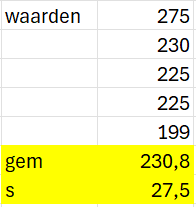
[picture p25: afbeeldingen/waarden 1A.png]



Uit deze test werden bovenstaande waarden verkregen. Binnen dit percentile driven protocol willen we een zo aangenaam mogelijk gewicht verkrijgen. Hierdoor wordt de strategie design for the mean toegepast zoals in bovenstaande staande figuur te zien is. Belangrijk is dat het gaat om het voorkeursgewicht en niet maximale. Na verwerking in excel volgt hieruit dat het gemiddelde gewicht 230,8g is.

**2a: Omtrek cilinder (database)**

Uit gebruikerstesten blijkt dat de gebruiker de cilinder op twee verschillende manieren vastneemt zoals hier onder te zien.

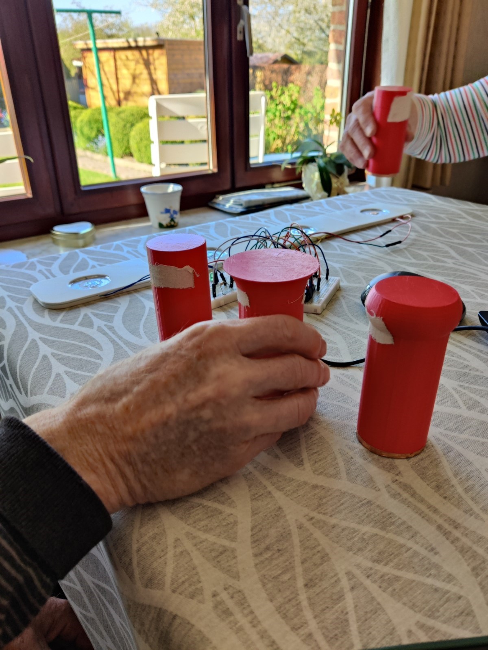
[picture p26: afbeeldingen/Gebruikerstest_Dev2_Grip1.jpg]

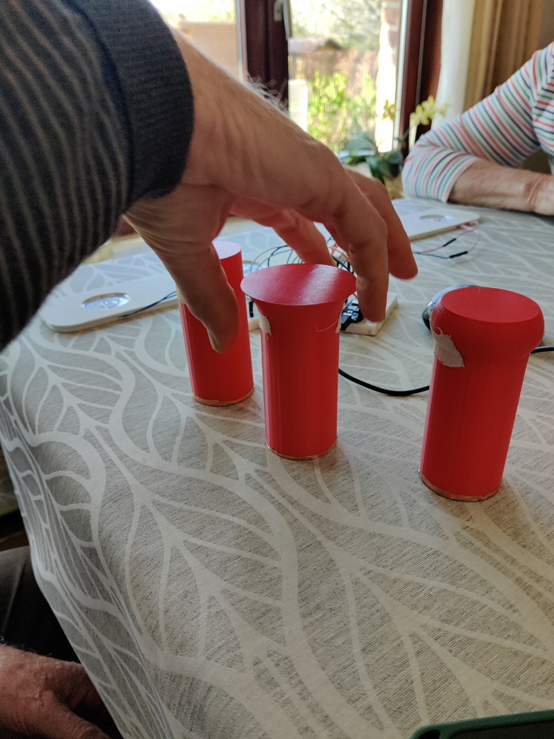
[picture p27: afbeeldingen/Gebruikerstest_Dev2_Grip2.jpg]


 één daarvan is met de volledige hand. Om dit te onderzoeken werden in de Dined database onderstaande parameters ingesteld. Hierbij zijn de grote waarden interessant. Aangezien een maximaal contactopp belangrijk is. Dus de omtrek is 129mm + 3*13=155mm. Hieruit volgt ideale diameter = 49,34mm. Belangrijk om te vermelden: deze gegevens zijn van leeftijden van 20-30j aangezien de leeftijden van 60+ers niet bekend is.
<p align="center">

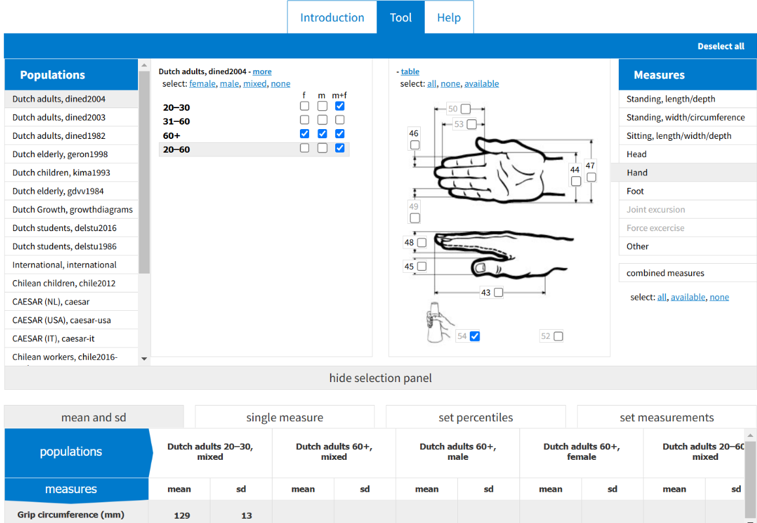
[picture p28: afbeeldingen/data 2A.png]
 

.

**2b: hoogte cilinder (database)**

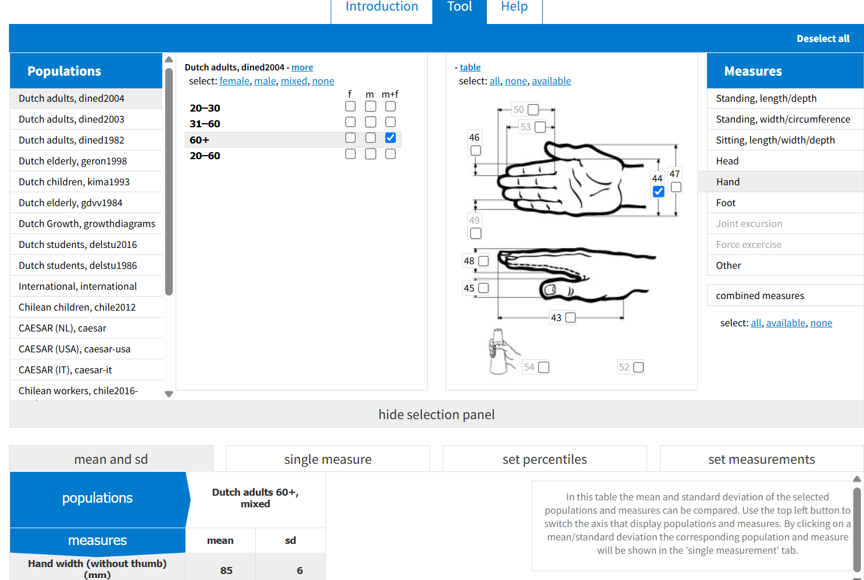
[picture p29: afbeeldingen/data 2B.png]


De database werd ingesteld zoals hierboven weergegeven. Aangezien hier de grootste handen de cilinder ook moeten kunnen vastnemen wordt weer design for the tall gebruikt. waarde = mean + 3 sd = 85+3*6=103mm

### Conclusies
**1: Meest ergonomisch gewicht**

De cilinders hebben elk een gewicht van 230,8g. 

**2a: Omtrek cilinder (database)**

Wanneer de waarden van de omtrek van de cilinders uit de database en de gebruikerstest vergeleken worden valt op dat deze vrij dicht bij elkaar liggen. Respectievelijk 49,34 mm en 45mm. Aangezien de gebruikers zelf voorhang hebben op databases wordt verder gerekend met 45mm

**2b: hoogte cilinder (database)**

De hoogte van de cilinder bedraagt 103mm.

> [!IMPORTANT]
> Design Requirements:
> - D2.6 De cilinder weegt 230,8g
> - D2.5 De hoogte bedraagt 103mm
### Wave 2 (N=4)
- [protocol](https://github.com/Thoma-D/UCD/blob/main/Bijlages/Develop/develop%202%20protocol.pdf)
- [rapport](https://github.com/Thoma-D/UCD/blob/main/Bijlages/Develop/develop%202%20rapport.pdf)
#### Doestellingen
1. Bepalen welke grip
2. communiceren dat cilinders goed contact hebben

    2a. Bepalen begrip contact LED's

    2b. vorm cutout

    2c. Keuze knop

3. keuze knop
#### Materiaal & methoden
- Knoppen
- extra scherm(protopie)
- Prototype docking station+ arduino/ bekabeling
- Cilinders (+weerstanden) 
-TAP & QAP
- **Bipolar emotional response testing (BERT)**
- **comparative usability testing**
#### Resultaten
#### 1. Cilinder-grip
<p align="center">


 </p>
Hiervoor werden 3 cilinder toppen met elkaar vergeleken in spel context en achteraf geevalueerd op meerdere categorieën met een comparative usability testing. De gebruiker werd gevraagd een score op 5 te geven op vlak van esthetiek en 5 op functionaliteit.
<p align="center">
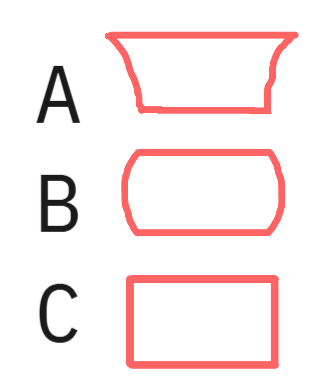
[picture p30: afbeeldingen/CilinderGripSoorten.png]

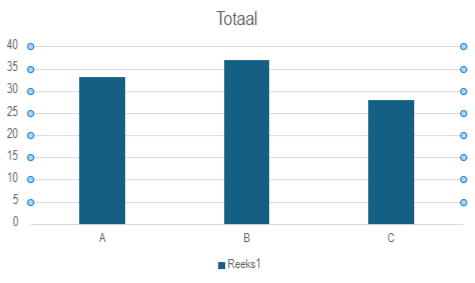
[picture p31: afbeeldingen/Gebruikerstest_Dev2_Totaal.jpg]

</p>

Uit deze test blijkt dat deze grip B door de meeste gebruikers gekozen wordt. Vervolgens grip A en als laatste C. 
> [!IMPORTANT]
> Design Requirements:
> - D2.7 B wordt gebruikt als grip

**2. communiceren dat de cilinders zeker een goed contact hebben**

Hiervoor werd onderstaand prototype gebouwd.
<p align="center">
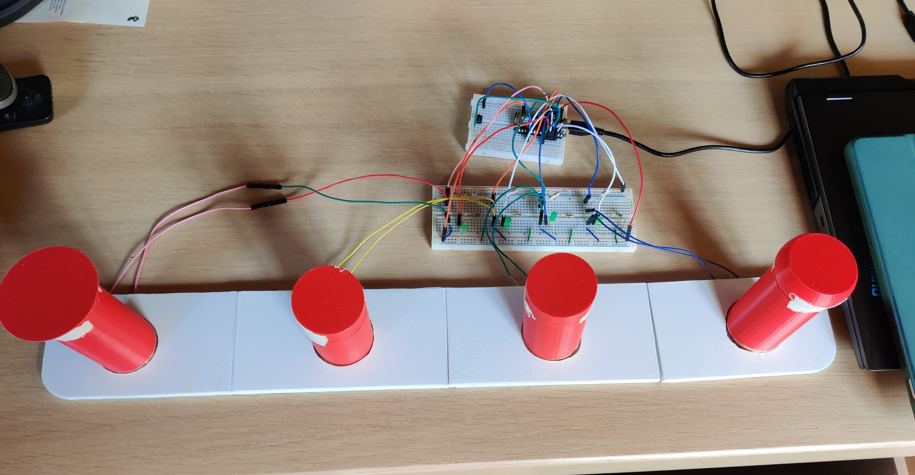
[picture p32: afbeeldingen/prototype.jpg]


#### 2a. vorm cutout
Om te zorgen dat de elektronische elementen correct worden gealinieerd worden inzinkingen voorzien waarin de cilinders inpassen. Deze affordance maakt ook duidelijk waar de cilinders moeten worden geplaatst op de docking station.
<p align="center">
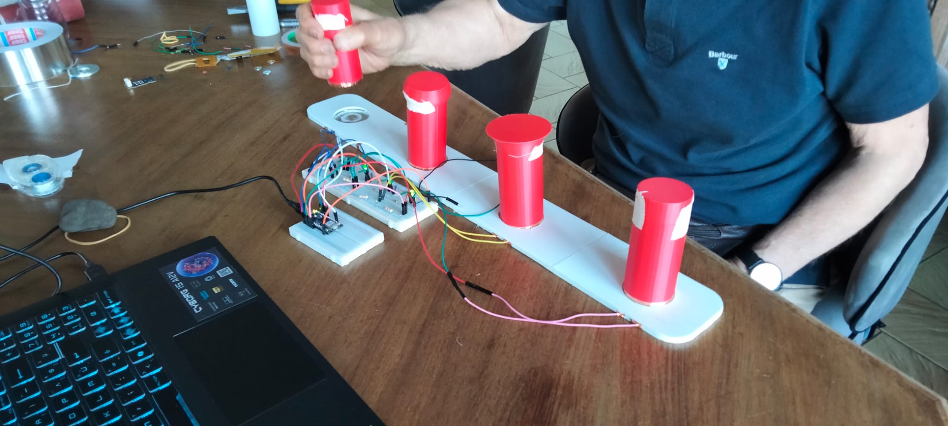
[picture p33: afbeeldingen/Gebruikertest_DEV2_GRIP2.jpg]

</p>
Tijdens de observatities werd vastgesteld dat deze hielpen bij het terugplaatsen van de cilinders.

Hieruit volgt D
#### 2b. LED's
 Er werd gestest in spel context of een LED die brand wanneer de cilinders een goed contact hebben een meerwaarde geven.
<p align="center">
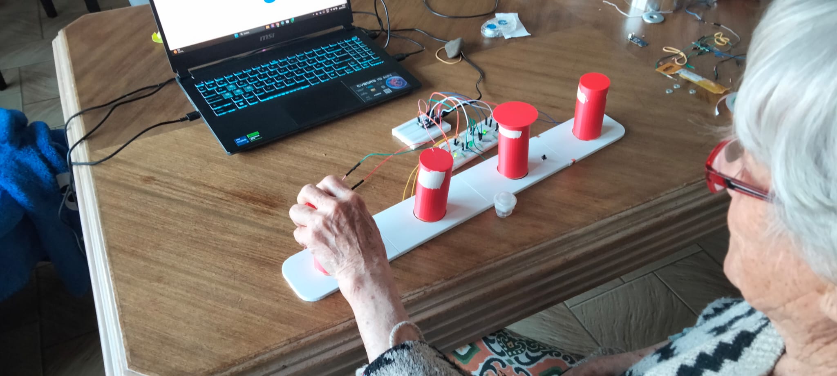
[picture p34: afbeeldingen/Gebruikertest_DEV2_GRIP.jpg]

</p>

#### 2c. Keuze knop
Hierbij werden meerdere knoppen en touchscreen opties met elkaar vergeleken adhv BERT testing.
<p align="center">
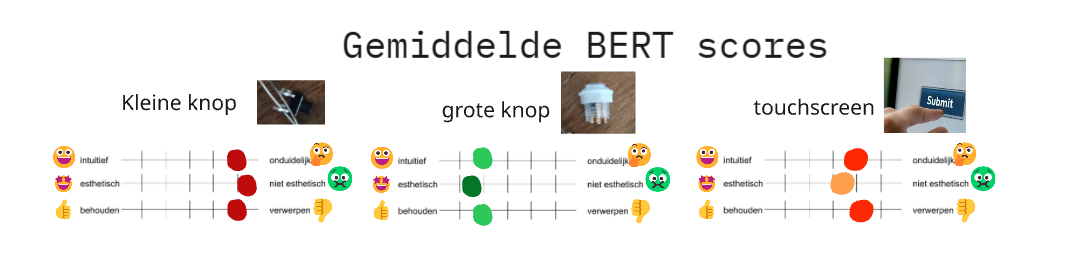
[picture p35: afbeeldingen/Gemiddelde BERT scores.png]

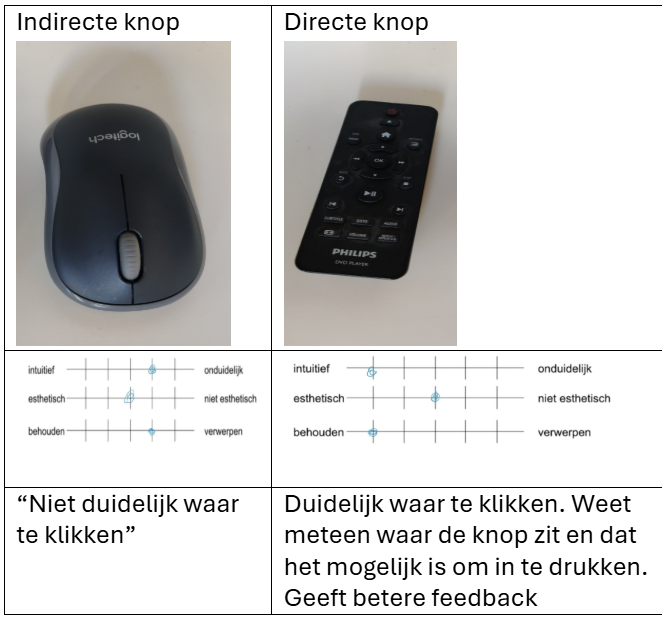
[picture p36: afbeeldingen/knop direct-indirect.png]


Hieruit volgt dat de gebruiker de "grote en directe" arcade knop verkiest.

> [!IMPORTANT]
> Design Requirements:
> - D2.7 De cilinders hebben grip B 
> - D4.5 De knop heeft een minimale diameter van 19mm
> - D4.6 De knop is een directe drukknop 
> - D4.7 De dockingstation bevat cutout's van de cilinders als affordance
> - D4.8 De dockingstation bevat LED's die aangeven wanneer de cilinders een goed contact maakt.
> - D4.9 De dockingstation bevat een arcade knop voor een spel te beëindigen

### Wave 3
- [protocol](https://github.com/Thoma-D/UCD/blob/main/Bijlages/Develop/develop%203%20protocol.pdf)
- [rapport](https://github.com/Thoma-D/UCD/blob/main/Bijlages/Develop/develop%203%20rapport.pdf)

#### Doestellingen

Interactie en fasen van het spel evalueren.

#### Materiaal & methoden
- Storyboard
- Camera
- extra scherm (protopie)
- Prototype docking station (+laptop))
- Cilinders (+weerstanden) 
- **performance measurement**
#### Resultaten

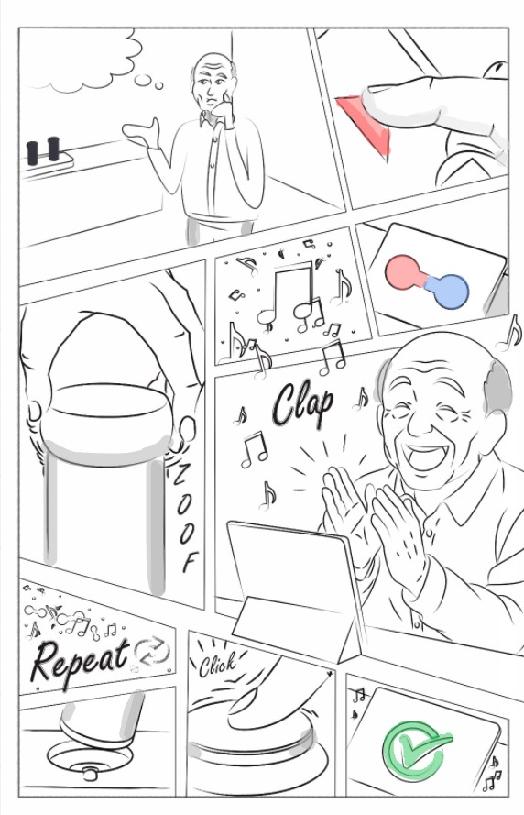
[picture p37: afbeeldingen/Storyboard_Kleur.jpg]


|

Uit bovenstaande storyboard werd de onderstaande tabel opgesteld voor het uitvoeren van een performance measurement.

|

| Nr. | Taak | Omschrijving | Moeilijk/makkelijk | Opmerking |
|-----|---|---|---|---|
| 1 | Aanzetten prototype | Gebruiker drukt op ronde knop in het midden. | | |
| 2 | Positioneren cilinders| Gebruiker zet de cilinders in willekeurige volgorde op het spelbord | | |
| 3 | Doorlopen demo | De gebruiker doorloopt a.d.h.v. het scherm de demo | | |
| 4 | Starten spel | De gebruiker drukt op ronde knop in het midden | | |
| 5 | Nemen cilinder | De gebruiker weet dat deze een cilinder moet nemen | | |
| 6 | Uitvoeren danspassen  | De gebruiker weet dat deze na het nemen van een cilinder de danspassen moet uitvoeren | | |
| 7 | Nemen tweede cilinder | De gebruiker weet dat deze een tweede cilinder moet nemen | | |
| 8 | Terugplaatsen | De gebruiker weet dat de cilinders in een andere volgorde kunnen worden terug geplaatst | | |
| 9 | Controleren | De gebruiker weet dat de middelste knop dient om te valideren | | |
| 10  | Uitzetten | De gebruiker kan het spel uitzetten door uit het stopcontact te trekken | | |

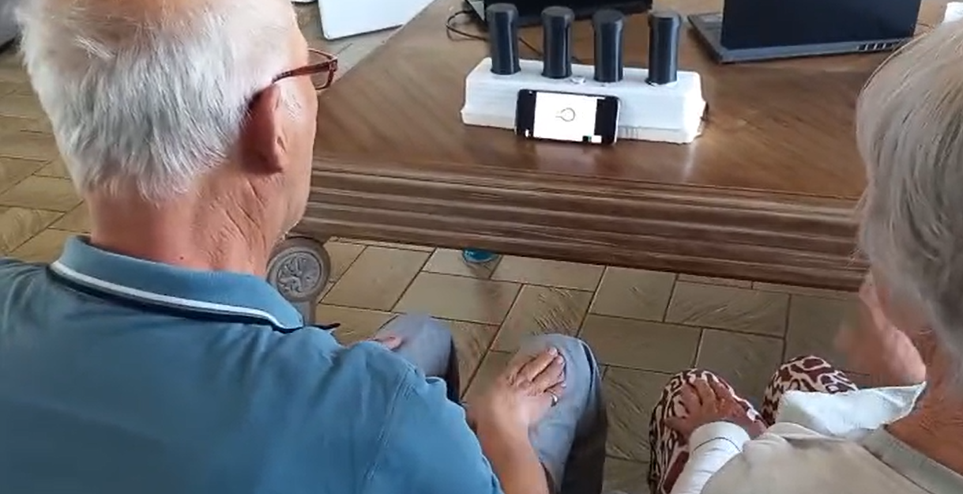
[picture p38: afbeeldingen/DEV_3_Test.png]


Hieruit volgende volgden dat 11/40 taken moeilijk verliepen, ookwel 27.5%. waarbij 75% moeite had met taken 2 en 3 en 50% met taken 4 en 6.

Uiteindelijk werden volgende oplossingen geimplementeerd voor de taken die moeilijk verliepen:

| Taak | Oplossing |
|---|---|
| 3 & 4 | Icoontje met “ok” toevoegen |
| 2  | Toevoegen folie |
|  2 | Cirkels rond knop en cilinders toevoegen |
| 3 & 4 | Extra scherm toevoegen met “druk om te starten” |
|6| uitleg ivm symbolen|

## Prototyping
### keuze elektronica
Een van de laatste zaken die moet bepaald worden is de keuze van de electronica. Daarvoor werd gestart vanuit een keuzematrix waarin de relavante mogelijkheden stonden. Deze matrix is hieronder weergegeven.
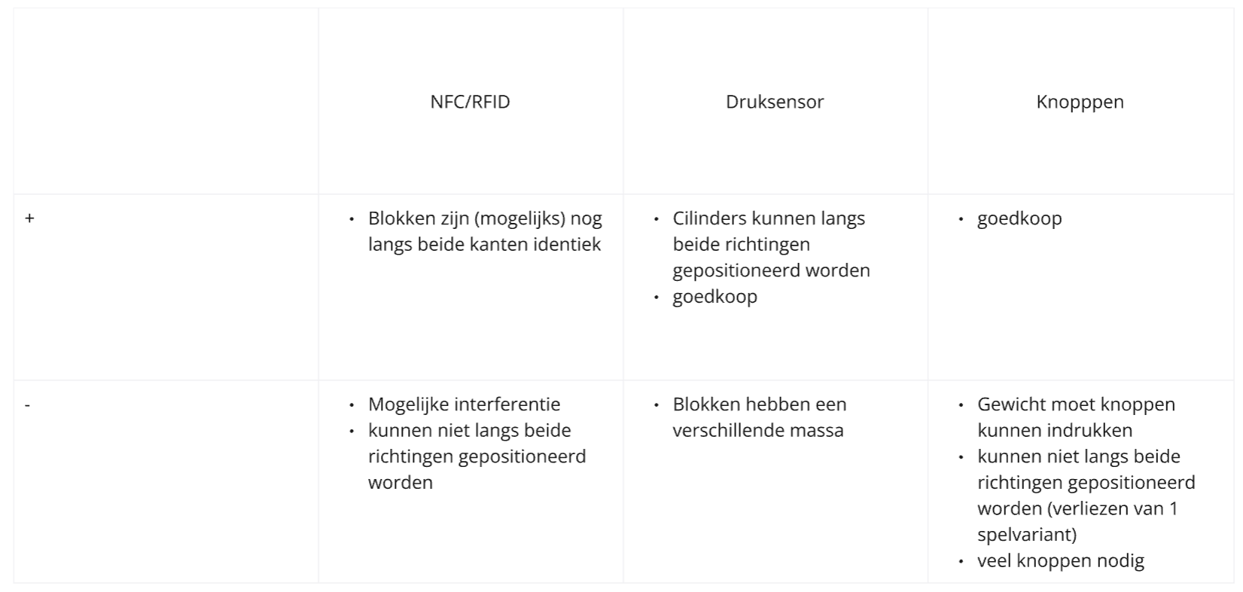
[picture p39: afbeeldingen/keuzematrix elektronica.png]


#### Druksensoren
Uit deze matrix blijken de druksensoren het interessantst te zijn. Dit vooral aangezien deze optie de enigste mogelijkheid biedt het spel ook met de cilinders omgedraaid te kunnen spelen. Helaas blijkt deze methode onnauwkeurig te zijn. Hierbij werd getest met vier DF9-40series druksensoren met een bereik van 20g - 2kg volgens onderstaande opstelling met spanningsdeler. De code hiervan is terug te vinden onder de map "code".
<p align="center">
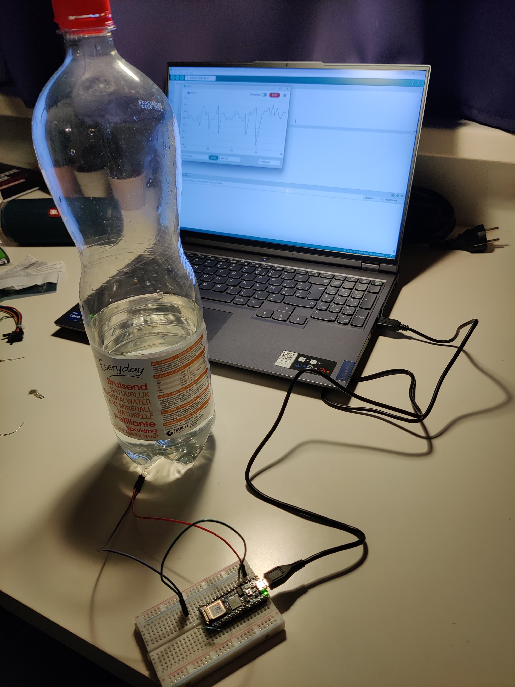
[picture p40: afbeeldingen/druksensor1.jpg]

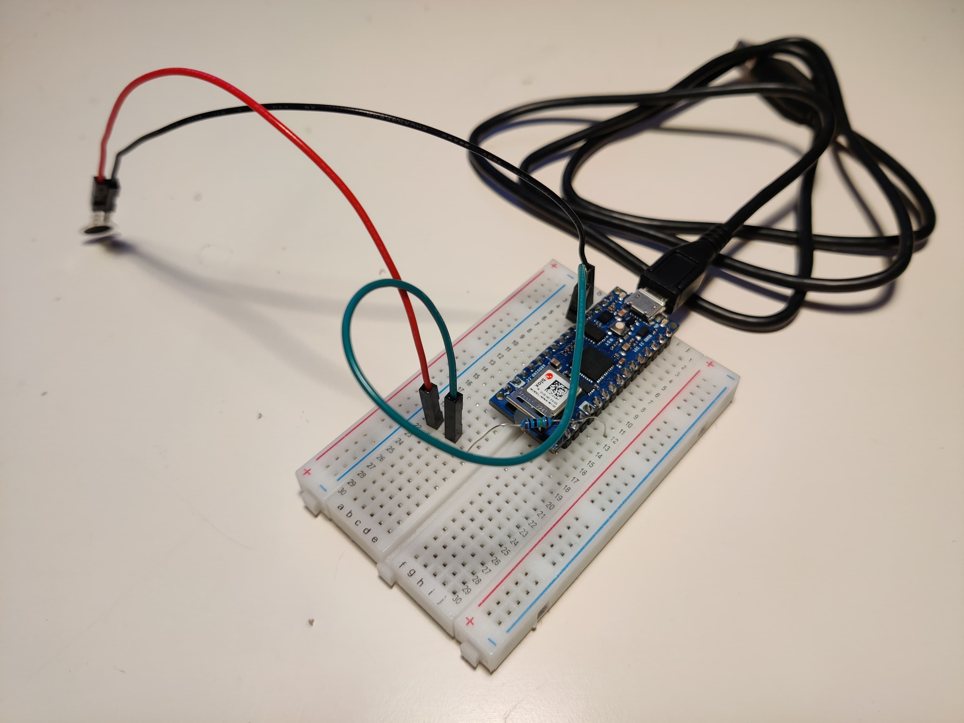
[picture p41: afbeeldingen/opstelling druksensor.jpg]

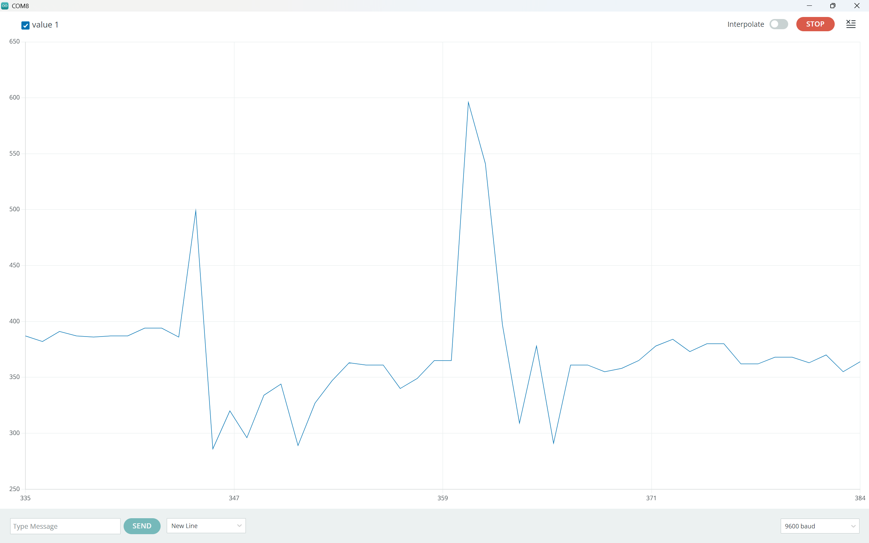
[picture p42: afbeeldingen/ruis_druk.png]

 </p>

>Praktische voordelen en uitdagingen druksensoren:
> - Goed in detecteren als er iets of niets opstaat
> - moeilijk te calibreren bij een constante indrukking
> - slechte gevoeligheid: Op huid heel gevoelig, op papier en andere materialen detecteert pas bij grote massa
#### RFID/NFC lezers
Om deze reden werd gekozen om vervolgens verder te werken met de RFID/NFC lezer. 

Uit onze testen hiermee bleek dat er **geen interferentie optrad tussen de tags**. Echter is het heel complex en ingewikkeld om vier lezers aan 1 arduino aan te sluiten. Voor 1 lezer blijken ook 7 aansluitingen nodig te zijn. Door het gebruik van 1 lezer zou er te veel aan gebruiksvriendelijkheid moeten worden ingeboet. De gebruiker zou op een bijkomstige manier de positie van de cilinder moeten ingeven. 
<p align="center">
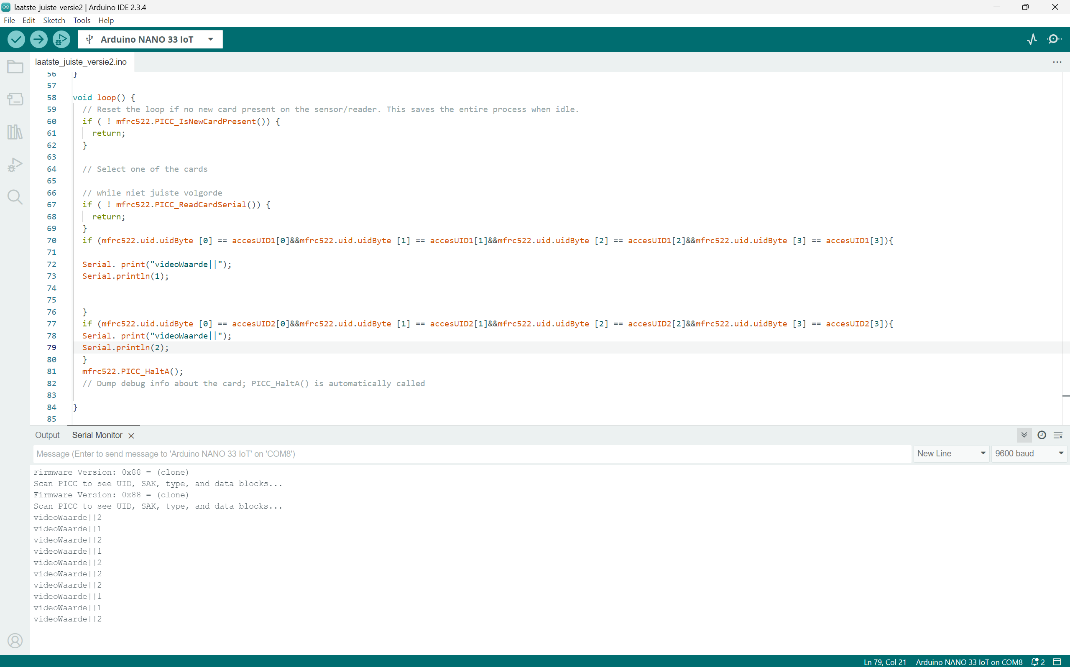
[picture p43: afbeeldingen/nfc output2.png]

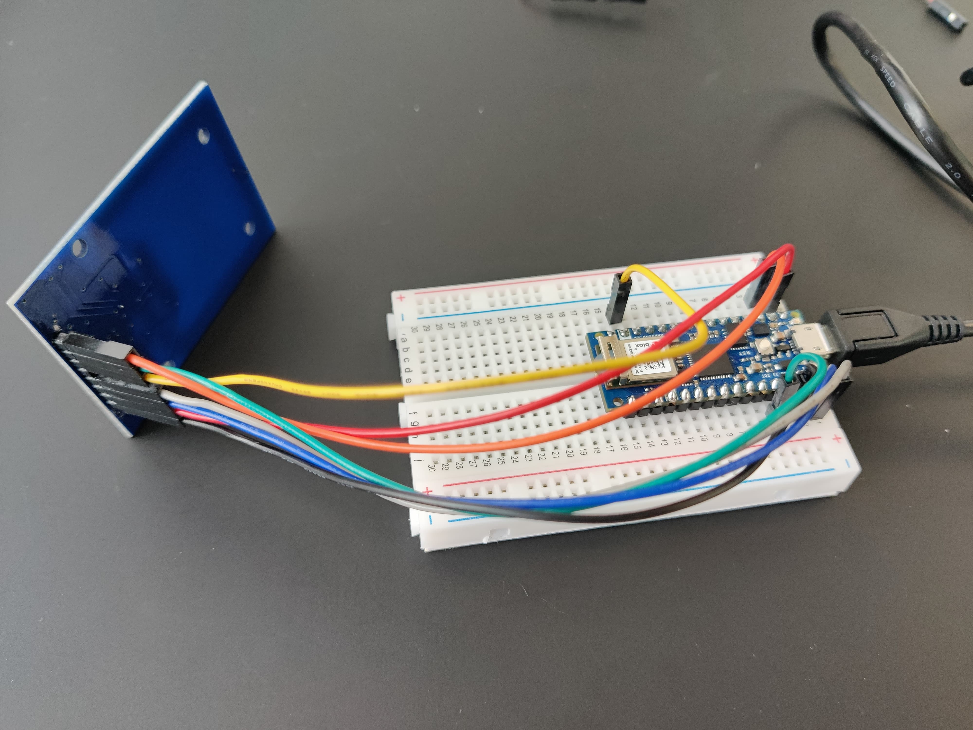
[picture p44: afbeeldingen/opstelling rfid.jpg]

</p>

>Praktische voordelen en uitdagingen RFID/NFC lezers
> - geen interferentie tussen naburige tags dus betrouwbaar
> - gebruik vier lezers nodig, lastig voor 1 enkele arduino
#### Weerstanden
Aangezien elk van voorgaande mogelijkheden te grote nadelen hadden -hetzij functioneel, hetzij aan gebruiksvriendelijkheid - werd nog naar andere mogelijkheden gezocht. Er werd een poging gedaan met weerstanden. Met behulp van spanningsdelers ten opzichte van telkens dezelfde referentieweerstand (R2=10000Ohm) kan makkelijk de positie worden waargenomen. De schakeling werd verder zo gemaakt dat **het verwijderen van de ene weerstand geen invloed heeft op de andere. Nog heeft het aantal gekoppelde weerstanden geen invloed op de analoge pins.**
<p align="center">
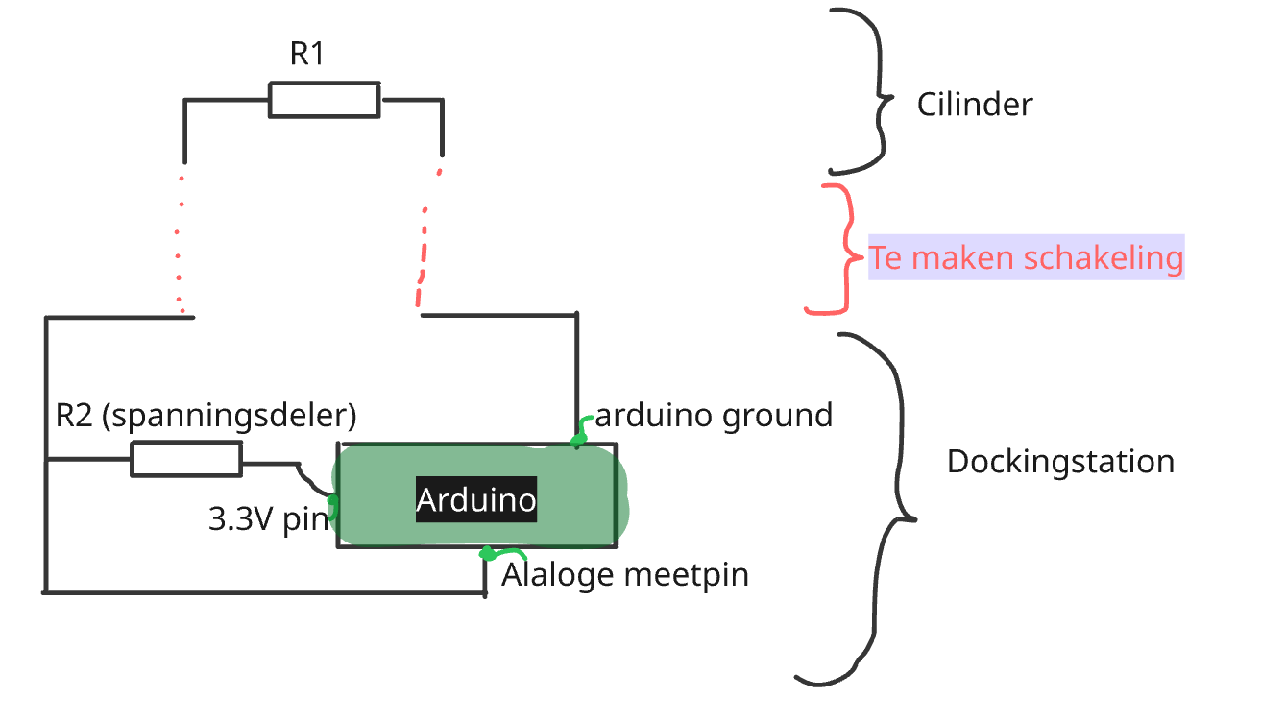
[picture p45: afbeeldingen/Schakeling_arduino_weerstand.jpg]

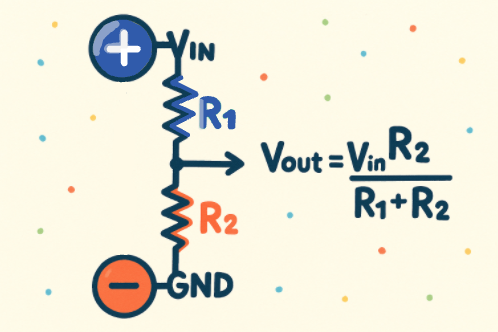
[picture p46: afbeeldingen/Spanningsdeler_Visualisatie.png]

</p>

**Keuze weerstandgroottes:**

Een analoge pin kan een waarde van nul tot 1023 vaststellen. Daarbij is het de bedoeling dat de vier weerstanden op die manier gekozen dat ze zo breed mogelijk gespreid zijn. Daarom werd een weerstand van - met een analogRead van - gekozen:
- R=1000 Ohm - analogRead= 930
- R=100000 Ohm - analogRead= 93
- R=3300 Ohm - analogRead= 770
- R=10000 Ohm - analogRead= 512

>Praktische voordelen en uitdagingen weerstanden
> - Nauwkeurige metingen, betrouwbare werking
> - Het contact tussen de docking station en de cilinders met de weerstanden
> - De schakeling moet onafhankelijk zijn van de richting waarin de cilinderbase t.o.v. de dockingstation wordt gemaakt 

### keuze connectie

Door gebruik te maken van 2 cirkels van geleidend materiaal waarover de weerstand staat hoeft de gebruiker geen rekening te houden met hoe de cilinder in de dockingstations wordt gezet, en zal deze altijd passen.

<p align="center">
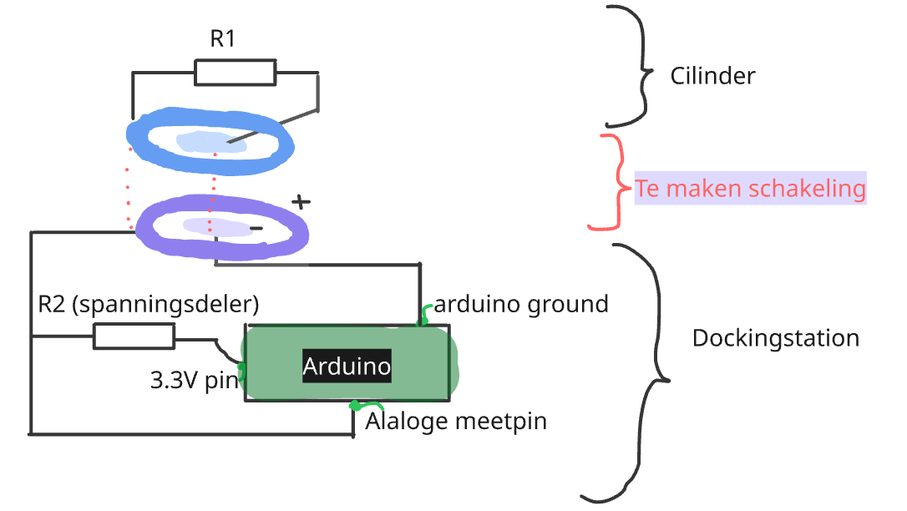
[picture p47: afbeeldingen/Schakeling_Onafhankelijk_Richting.jpg]

</p>

**voorselectie: keuzematrix materiaalkeuze op basis van voorkennis:**

||Geleidende tape| Sheet metal| Sluitringen|Al folie|Geleidende verf|
|:---|:---|:---|:---|:---|:---|
|+| Snel mee te werken, esthetisch||Esthetisch, moet niet meer bewerken| Makkelijk voor prototypes, makkelijk bewerkbaar|vormvrijheid, |
|-|lastig om cirkelvormige ringen mee te maken|moeilijk vervormbaar|vormen staan al vast (geleid)|niet esthetisch|weinig kleur, duur|

**Def-selectie: keuzematrix op basis van praktische test**

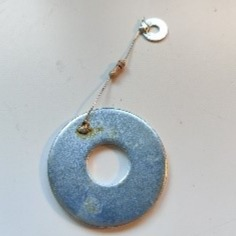
[picture p48: afbeeldingen/1_Rondel Rondel verbonden met soldeer.jpg]
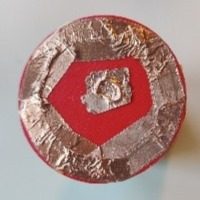
[picture p49: afbeeldingen/2_Al_Cu-tape.jpg]
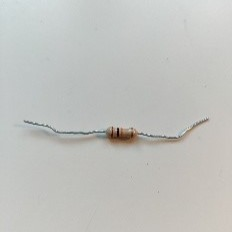
[picture p50: afbeeldingen/3_Rechtreeks.jpg]
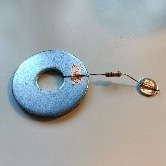
[picture p51: afbeeldingen/4_Rondel Rondel verbonden met Cu-tape.jpg]
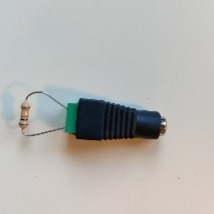
[picture p52: afbeeldingen/5_Adapter.jpg]
||Rondel Rondel vebonden met soldeer| Al/Cu-tape| Rechtstreeks|Rondel Rondel verbonden met Cu-tape |Adapter |
|:---|:---|:---|:---|:---|:---|
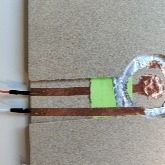
[picture p53: afbeeldingen/6_Al_Cu- (met pin).jpg]
|**Al/Cu- (met pin)** |/|Slecht contact zowel met pins als indrukken|/|/|/|
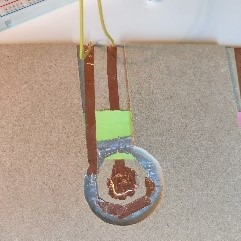
[picture p54: afbeeldingen/7_Al_Cu- (zonder pin).jpg]
|**Al/Cu (zonder pin)** |/|goed contact|goed contact|/|/|
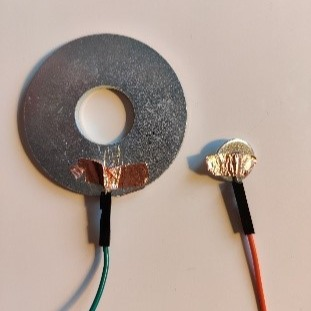
[picture p55: afbeeldingen/8_Rondel met Cu-draad (met pin).jpg]
|**Rondel met Cu-draad (met pin)** |Slecht contact bij pin, goed contact tussen de rondellen|/|Slecht contact bij pin, goed contact tussen ronddelen|Slecht contact bij pin, goed contact tussen de rondellen|/|
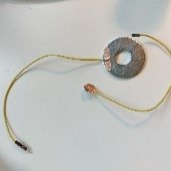
[picture p56: afbeeldingen/9_Rondel met Cu-draad (zonder pin).jpg]
|**Rondel met Cu-draad (zonder pin)**|Goed contact|/|goed contact bij licht drukken|Goed contact|/|
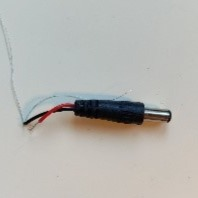
[picture p57: afbeeldingen/10_adapter.jpg]
|**Adapter** |/|/|/|/|Goed contact|

### Productie definitieve ontwerp
#### componenten:
Uit de vorige waves, klantbehoeften en uit het gedeelte design volgt dat het product volgende componenten moet bevatten:
- 4 cilinders
- scherm
- centraal station met:
  - 4 openingen voor de "lezers"
  - 1 drukknop als "ok" en "validatie" knop
  - 4 Leds om contact te detecteren (feedback)

#### positie componenten: 
Daarbij kan het geheel op onderstaande manieren geplaatst worden
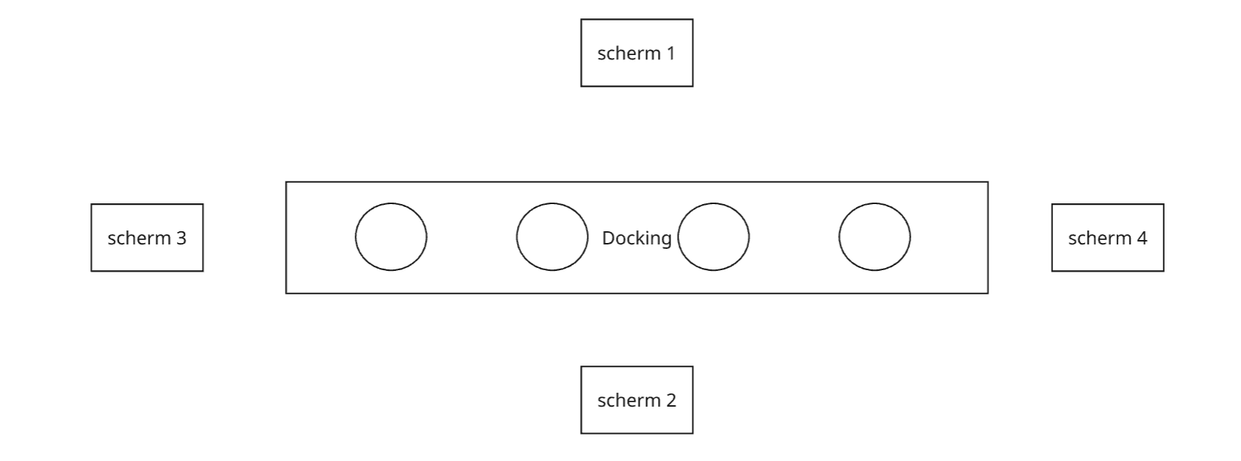
[picture p58: afbeeldingen/positie.png]


Scherm optie 1 en 2 gaan niet omdat deze het zicht hinderen. 3 en 4 is afhankelijk van rechts of linkshandigen. Hieruit wordt besloten dat het scherm volledig appart en op voorkeur van de gebruiker geplaatst wordt.

#### technieken:
Keuzematrix met design blocks:
||1|2|3|4|
|:---|:---|:---|:---|:---|
|materiaal|MDF|PLA|hout|Foam
|productietechniek|3D printen|thermovormen|lasercutten|spuitgieten
|verbindingsmechanismen|schroef|klik|vaste passing|lijm

- cilinders: voor de cilinders wordt **3D printing** toegepast. Dit omdat het hier om een cilindrisch element en een beperkte hoeveelheid gaat. Bij hogere productie kan bv naar thermovormen gekeken.

- dockingstation: Het dockingstation bestaat uit een combinatie van **lasercutten en thermovormen**. Thermovormen omdat in weinig stappen een strak bovenste surface met gebogen zijkante ontstaat. Een deel van de matrijs kan daarbij behouden worden. Wat in weinig materiaalverlies resulteert. Om te verzekeren dat de lezers langs de bovenkant niet inzakken worden nog twee lagen gelasersneden.

#### Opbouw
<p align="center">
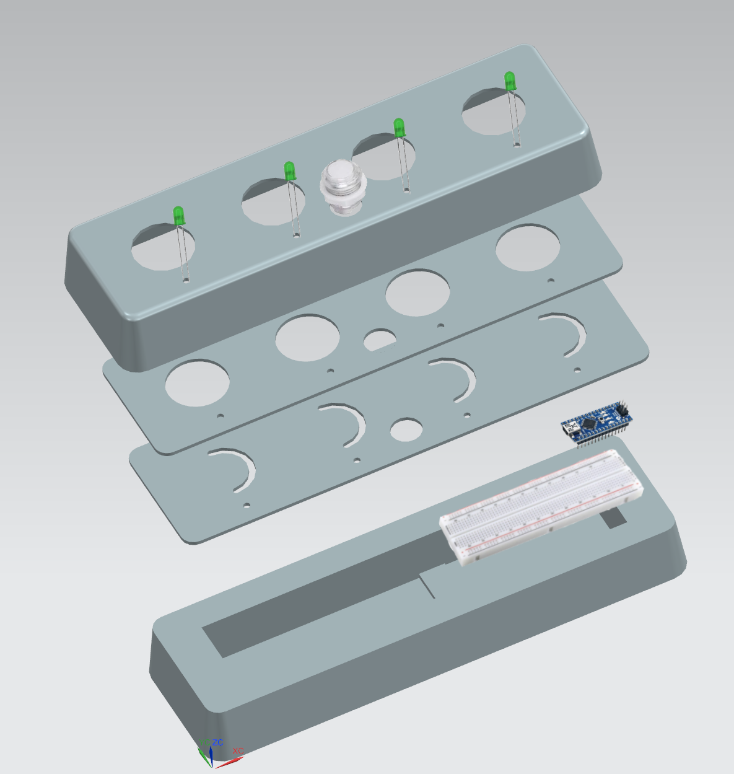
[picture p59: afbeeldingen/assy.png]


## Design
Het design van dit product vloeit voort uit:
- Design principes Dieter Rams
- gestalt wetten
- moodboard
- Algemene design principes

Om de tekst te beperken werd van enkele principes weergegeven hoe hiermee in het product rekening werd gehouden. In realiteit is dit dus uitgebreider.
### Design principes Dieter Rams
Dieter Rams is een bekende Duitse ontwerper. Zijn tien algemene ontwerpregels worden hieronder weergegeven.

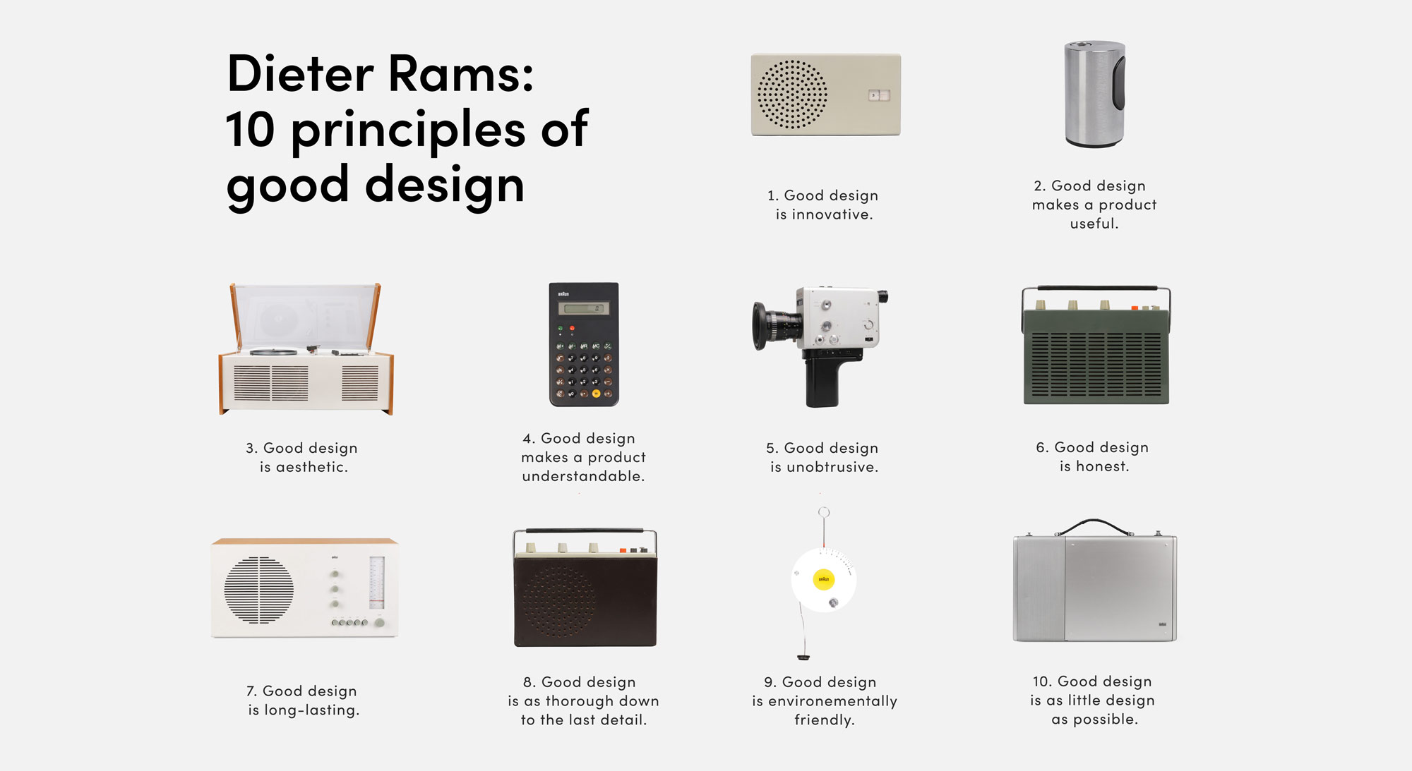
[picture p60: afbeeldingen/10-principles-good-design-rams-dieter.jpg]


In dit ontwerp werd o.a. veel aandacht besteed aan:
- principe één: good design is innovative: De theoretische werking is **nooit eerder zo ontwikkeld tot een product**. Hiervoor was er enkel een beamer en projector.
- principe twee: good design makes a product useful:
Doorheen dit proces werd gekeken hoe we onze how might we zo efficiënt mogelijk konden oplossen. Daarbij werd gekeken dat de theoretische werking behouden werd zonder onnodige toevoegingen aan te brengen. In ons ontwerp is dit te zien door **geen onnodige knoppen en functies** aan te brengen.
- principe drie: good design is aesthetic:
Hieraan werd voldaan door niet enkel vanuit een functioneel oogpunt te starten maar ook vanuit een moodboard...
### Gestalt wetten
Deze geven weer hoe de gebruiker objecten interpreteerd. Door het toepassen van deze wetten verloopt de interactie tussen gebruiker en product vlotter. 

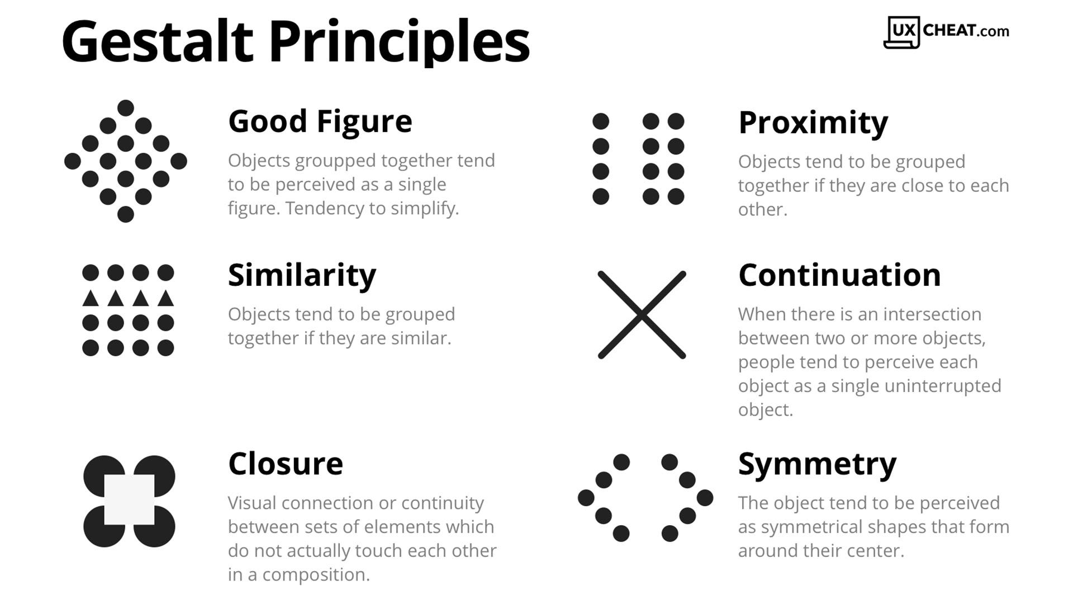
[picture p61: afbeeldingen/gestalt.jpg]


- **similarity**: Om duidelijk te maken dat de **cilinders bij elkaar horen krijgen deze dezelfde kleur.**

- **Closure**: Om duidelijk aan te tonen dat de **cilinders bij elkaar horen worden deze op het zelfde begrensde oppervlak** gezet. Dit is verschillend van de blok met de arduino en het scherm. 

### Moodboard
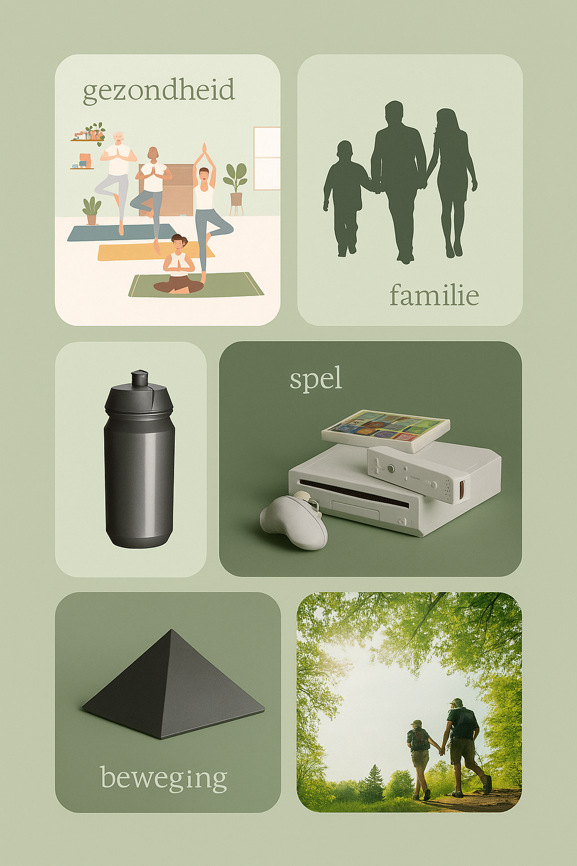
[picture p62: afbeeldingen/Moodboard+.png]


- materiaalkeuze docking:
Om het docking een "glossy" uiterlijk te geven zoals in het moodboard wordt een plastic plaat gebruikt.
- texture cilinders:
**Oogt premium, is zweet absorberend**. Maar moeilijk om effectief toe te passen.
- grip cilinders:
Zoals de bidon in het moodboard wordt ook bij de cilinders een **grip toegevoegd**. De vorm van die grip is al eerder in develop twee onderzocht.

### Algemene design principes
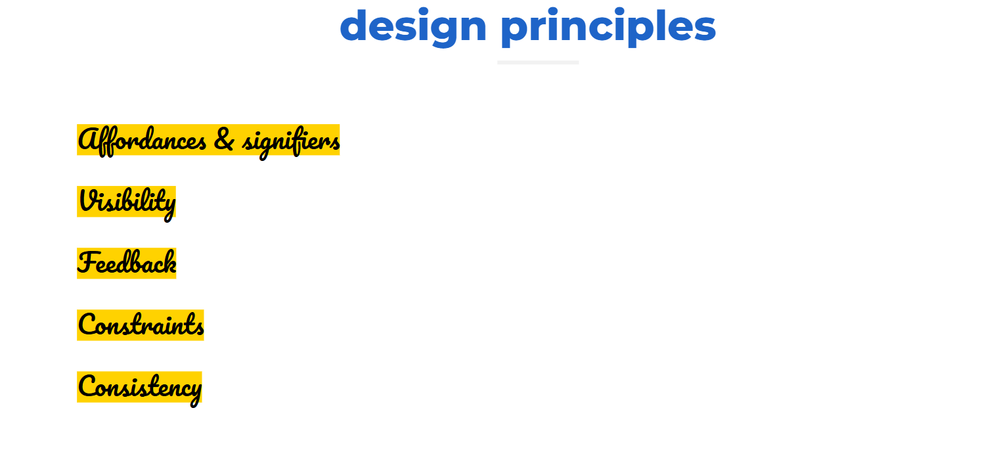
[picture p63: afbeeldingen/design principes.png]


- **constraints**: De verbinding tussen de cilinder en het docking station zijn beide cilindervormig. Doordat de vier openingen en de vier cilinders de zelfde zijn is het duidelijk dat eender welke cilinder op eender welke plaats kan komen.
- **Feedback**: De **leds branden wanneer de cilinder contact maakt met het dockingstation**.
<p align="center">
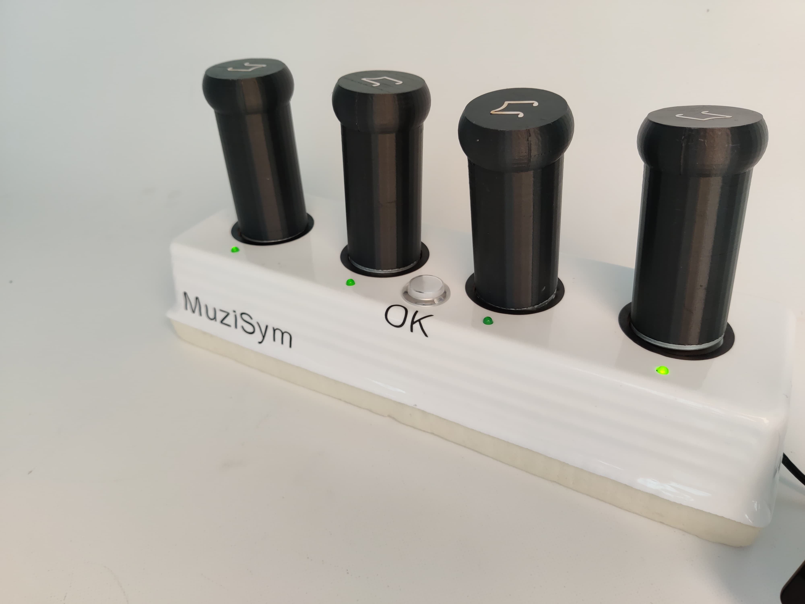
[picture p64: afbeeldingen/brandende leds.jpg]


- **Affordances**: Door de openingen en **zwarte cirkels** in het docking station kan de **gebruiker afleiden dat hier een cilinder in komt**. Dit kan ook als **nudging** gezien worden aangezien bepaald gedrag wordt uitgelokt.  Door de grip bovenop de cilinder is de gebruiker rapper geneigd de cilinder vast te nemen.
<p align="center">
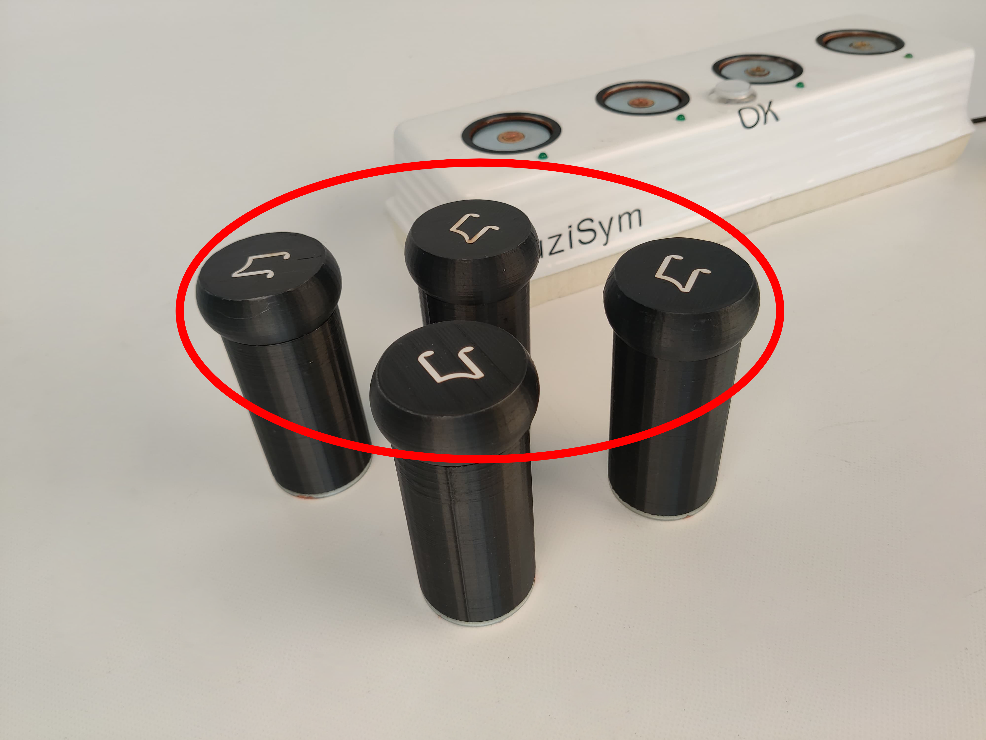
[picture p65: afbeeldingen/grip.png]


### Render
Op basis hiervan werd met Siemens NX, Vred en Affinity onderstaande renders gemaakt. 

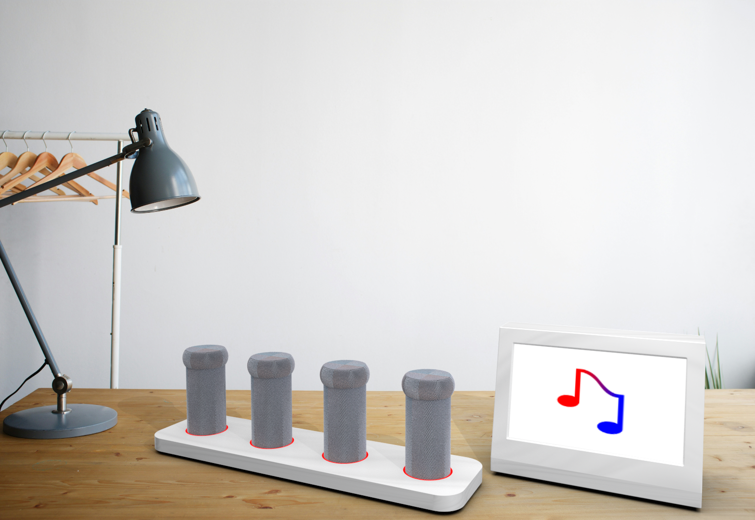
[picture p66: afbeeldingen/render_eindok.png]

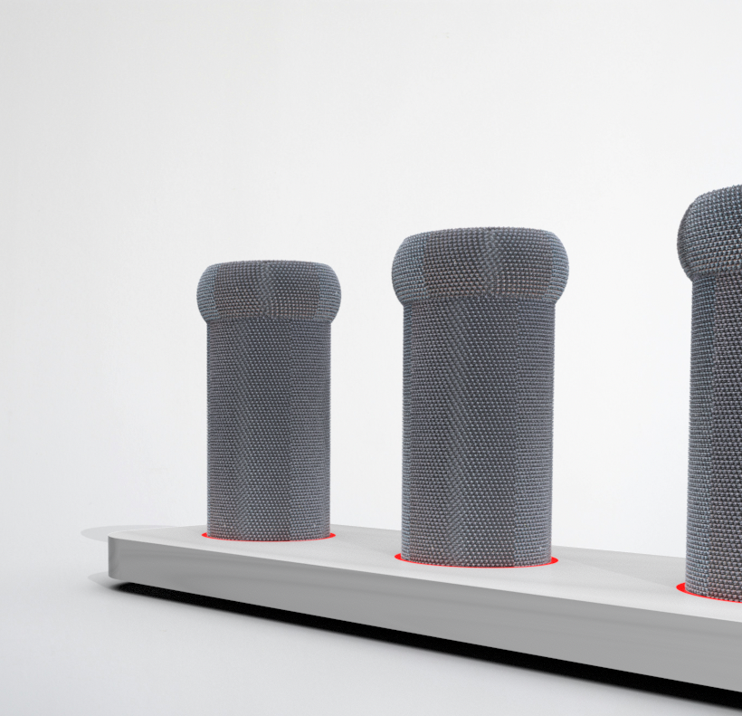
[picture p67: afbeeldingen/render_grip.png]


## Verder kijken
Uit de laatste les gebruiksgericht ontwerpen (13/05) in de Krook volgde uit de PESTEL methode voorgesteld door andere studenten dat op economisch vlak MuziSym rendabel kan zijn door naast de aankoop ook nog een service met meer nummers en danspassen te leveren.

## Overzicht Design Requirements

|ID|Design Requirement|Source|
|:---|:---|:---|
|**Groep 1**|**Algemeen**|
|1.1|Het product moet meerdere hersengebieden activeren|[Literatuurstudie](#literatuurstudie-n10) bron 1|
|1.2|Het product moet in groep te kunnen gebruiken zijn|[Literatuurstudie](#literatuurstudie-n10) bron 2|
|1.3|Het product moet fouten maken toelaten |[Literatuurstudie](#literatuurstudie-n10) bron 2|
|1.4|Het product moet muziek bevatten|[Literatuurstudie](#literatuurstudie-n10) bron 1,2,3,7,10|
|1.5|Het product moet ritme bevatten|[Literatuurstudie](#literatuurstudie-n10) bron 6|
|1.6|Het product moet de ervaring geven/ er in slagen dat de doelgroep er steeds beter in wordt |[Literatuurstudie](#literatuurstudie-n10) bron 2|
|1.7|Het product moet verschillende moeilijkheid niveaus bevatten|[Interviews](#interviews-n4) 1,2|
|1.8|Een sessie moet geleidelijk opbouwen |[Interviews](#interviews-n4) 1,2|
|1.9|De muziek moet instelbaar of gekend zijn |[Interviews](#interviews-n4) 1|
|1.10|Het product moet thuis te gebruiken zijn |[Interviews](#interviews-n4) 2|
|1.11|Het product moet voor zowel individuele (eenzame) als meerdere personen tegelijkertijd geschikt zijn |[Interviews](#interviews-n4) 2|
|1.12|Het product moet een alternatief voor dans kunnen bevatten|[Interviews](#interviews-n4) 3|
|1.13|Het product moet buiten te gebruiken kunnen zijn |[Interviews](#interviews-n4) 4|
|1.14|Het product moet zo weinig mogelijk schermen, verbinding met smartphones en tablets bevatten|[Interviews](#interviews-n4) 1|
|1.15|Het product moet de mogelijkheid geven het muzieknummer vooraf volledig te spelen |[Wave 1](#wave-1-n5)|
|1.16|Het product moet veilig te gebruiken zijn |[Wave 1](#wave-1-n5)|
|1.17|De gebruiker heeft de mogelijkheid om zijn vooruitgang te zien |[Wave 2](#wave-2-n5)|
|**Groep 2**|**Interactieve blokken**|
|2.1|Het product moet vier interactieve blokken bevatten|[Wave 1](#wave-1-n5)|
|2.2|De interactieve blokken moeten zowel een te onderscheiden als een niet te onderscheiden kant hebben (1kant allemaal dezelfde kleur, 1 kant allemaal een verschillend kleur)|[Wave 1](#wave-1-n5)|
|2.3|De interactieve blokken zijn cilindervormig, om duidelijk 2 verschillende kanten te hebben, met elk zijn unieke functie|[Wave 1](#wave-1-n5)|
|2.4|De interactieve blokken hebben een hoogte en straal van 45mm|[Wave 2](#wave-2-n5)|
|2.5|De hoogte bedraagt 103mm|[Develop 1](#develop-1-ergonomie-deel-1)|
|2.6|De cilinder weegt 230,8g|[Develop 1](#develop-1-ergonomie-deel-1)|
|2.7|De cilinders hebben grip B.|[Develop 2](#develop-2-n4)|
|**Groep 3**|**Interface/scherm**|
|3.1|De interface van het product moet hoofdzakelijk uit woorden bestaan.|[Wave 2](#wave-2-n5)|
|3.2|De interface moet eenvoudig en beperkt blijven|[Wave 2](#wave-2-n5)|
|3.3|De schermgrootte ligt tussen 6.7" en 10.9" |[Wave 2](#wave-2-n5)|
|3.4|Onderstaande interface structuur wordt gebruikt |[Wave 2](#wave-2-n5)|
|**Groep 4**|**Docking station**|
|4.1|Het product moet esthetisch aantrekkelijk zijn |[Wave 2](#wave-2-n5)|
|4.2|Het product moet feedback geven aan het einde van een spelsessie|[Wave 2](#wave-2-n5)|
|4.3|De docking station van het product moet een speaker bevatten|[Wave 1](#wave-1-n5)|
|4.4|Het product moet duidelijk aangeven wat rechts(rood) en wat links(blauw) is|[Wave 1](#wave-1-n5)|
|4.5|De knop heeft een minimale diameter van 19mm |[Develop 2](#develop-2-n4)|
|4.6|De knop is een directe drukknop |[Develop 2](#develop-2-n4)|
|4.7|De dockingstation bevat cutout's van de cilinders als affordance|[Develop 2](#develop-2-n4)|
|4.8| De dockingstation bevat LED's die aangeven wanneer de cilinders een goed contact maakt |[Develop 2](#develop-2-n4)|
|4.9|De dockingstation bevat een arcade knop voor een spel te beëindigen|[Develop 2](#develop-2-n4)|

## Kritische reflectie
### theorie <-> praktijk
Ondanks dat er veel tijd besteed is aan het nagaan van een goed lezer-sensor mechanisme (druksensor -> rfid -> weerstand) bleven er na het toevoegen van delays, extra geleidend materiaal en leds als feedback toch veel slechte contacten over. Dat niet alles wat perfect in theorie werkt, ook in de praktijk werkt.
### Arduino <-> Raspberry Pi
De arduino bleek nogal traag en onbetrouwbaar te zijn bij het uploaden van code. De volgende keer kan een raspberry pi een mogelijke oplossing zijn.
### Verhaal <-> to the point
Tijdens dit proces leerden we van wat in het begin eerder een verhaal en doorlopende tekst was naar een gestructureerd en to the point ontwerpproces te gaan. Een mooi voorbeeld daarbij is het verschil tussen de eerste wave (literatuurstudie en gebruikerstest) dat vooral een tekst is en de laatste wave (develop drie) wat een mooie gestructureerde tabel is. 
Niet 
-> boomstructuur interface
Op 
-> niet alle klantbehoeften kondnen worden waargemaakt. Een voorbeeld daarvan is 
## Bronnen
[1] Pohl, P. (2018). The Ronnie Gardiner Method: An Innovative Music-Based Intervention for Neurological Rehabilitation - Theoretical Background and Contemporary Research with Focus on Parkinson’s Disease. Neurophysiology And Rehabilitation, 32–37. (https://edelweisspublications.com/edelweiss/article/ronnie-gardiner-method-innovative-music-based-intervention-neurological-rehabilitation-theoretical-background-npr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)

[2] Music supported therapy in neurorehabilitation. (z.d.). Oxford Textbook Of Neurorehabilitation (2 Edn). https://research.gold.ac.uk/id/eprint/29275/1/med-9780198824954-chapter-31.pdf

[3] Nws, V. (2022, 13 april). Tweetaligheid houdt de hersenen jong. vrtnws.be. https://www.vrt.be/vrtnws/nl/2022/04/13/tweetaligheid-houdt-de-hersenen-jong/

[4] Home. (z.d.). RGM Nederland. https://rgm-nederland.nl/site/home

[5] Rianne Stouten. (2022, 31 oktober). RGM - een introductie [Video]. YouTube. https://www.youtube.com/watch?v=f69yf9YW_Cw

[6]https://www.pnas.org/doi/pdf/10.1073/pnas.78.11.7124
## Bijlagen
[figma woorden](https://www.figma.com/design/PEY1bDh1OrohykHiABHBeu/Untitled?node-id=0-1&m=dev&t=fQvcs61jFtjjBYOr-1)

[figma symbolen](https://www.figma.com/design/PEY1bDh1OrohykHiABHBeu/Untitled?node-id=0-1&m=dev&t=e6Q9ih9GOHFj0thw-1 )

[protopie interface](https://cloud.protopie.io/p/c16a901406f66f9149030187)
