Thoma-D/UCD/Bijlages/Develop/develop 1 rapport.pdf

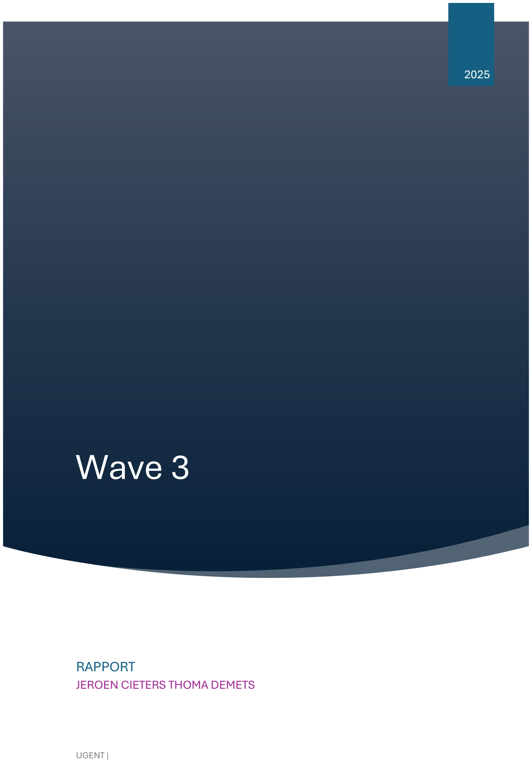
[picture p68: page 1]

# Wave 3

2025

RAPPORT
JEROEN CIETERS THOMA DEMETS

UGENT |

Inhoudsopgave

A: Adhv gebruikerstest om rechtstreekse input van de gebruiker te krijgen.........1

A: Werd eerder adhv gebruikerstest bepaald. Ditmaal wordt opnieuw database

Doelen
Doel 1: ergonomische massa
Meest ergonomische massa bepalen.
A: Adhv gebruikerstest om rechtstreekse input van de gebruiker te krijgen B: Uit arm moment bepalen

Doel 2: ergonomische afmetingen
A: Werd eerder adhv gebruikerstest bepaald. Ditmaal wordt opnieuw database gebruikt voor een grotere steekproef
B: Hoogte

Uitwerking
1a : Test bepalen “ideale” massa
Doel:
Er wordt bepaald welke massa voor de gebruiker aangenaam te hanteren is. Werkwijze:
- Er worden 2/3 massa’s met een verschil van 100g aan de gebruiker voorgeschoteld, om deze door hen te laten vergelijken.
- Hieruit kiezen ze hun voorkeur, vervolgens wordt vanaf deze massa, met een kleiner verschil (50g, 25g) deze stap herhaald. Dit tot hun ideale massa is bepaald.

Bepalen ideale massa adhv Gebruikerstest

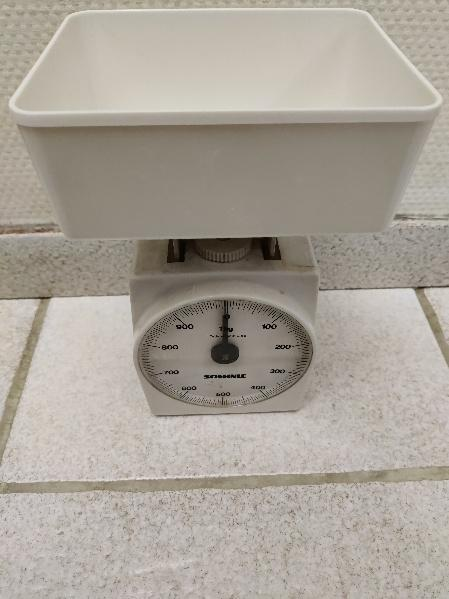
[picture p69: figure]
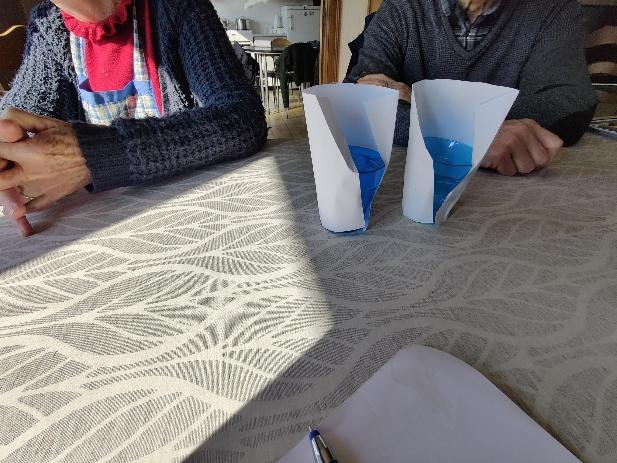
[picture p70: figure]

Ruwe data:
Weergegeven zijn de voorgeschotelde massa’s per ronde, met telkens hun bijhorende keuze(s) aangeduid in fluo.

Test 1:
Ronde 1: 200g 300g 400g
Ronde 2: 250g 300g 350g
Ronde 3: 250g 275g 300g

Test 2:
Ronde 1: 200g 300g 400g
Ronde 2: 200g 250g 300g
Ronde 3: 200g 225g 250g

Test 3:
225g
Test 4:
225g
Test 5:
199g

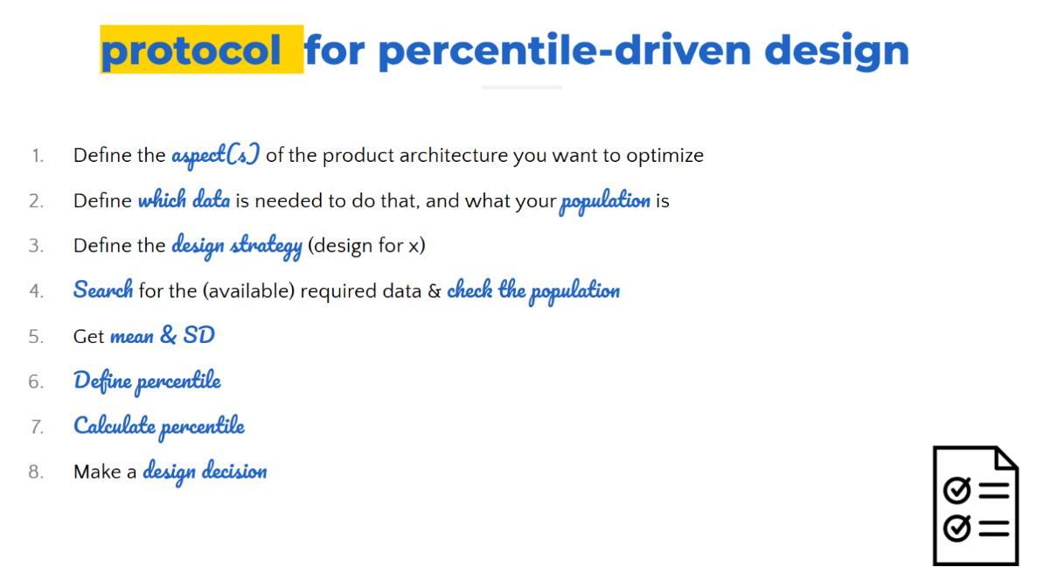
[picture p71: figure]

Uitwerking

1. Aspect: optimaliseren fysieke ergonomie: bepalen gewicht
2. Hierbij werd vooraf een gebruikerstest afgelegd, om zo een “ideale” massa vast te leggen, met de data hieruit werd gerekend.
3. Aangezien het niet gaat om maximale gewicht maar om voorkeursgewicht wordt de design for the mean strategie toegepast.
4. Source relevant data: https://dined.io.tudelft.nl/en/reach-envelopes/introduction (https://dined.io.tudelft.nl/en/reach-envelopes/introduction)
5. gemiddelde = som gewichten/aantal, standaardafwijking

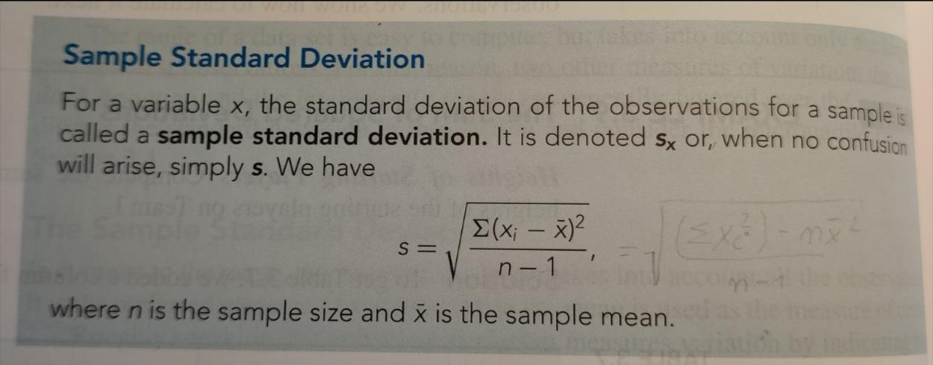
[picture p72: figure]

Formule uit introductory statistics 10th edition

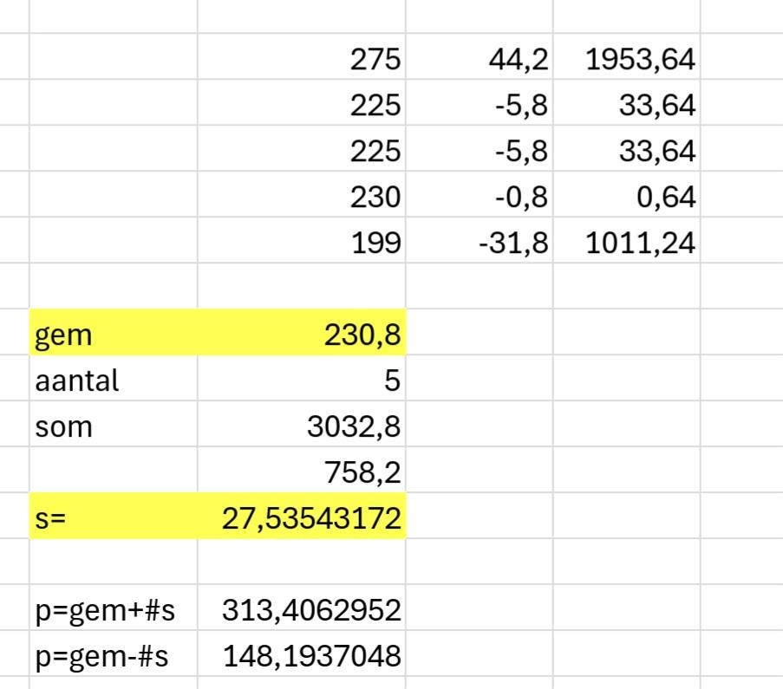
[picture p73: figure]

Het Excel bestand is in GitHub als bijlage te vinden.

6. Aangezien mean gemiddelde nodig
7. Gemiddelde 230,8g. 50% van de gegevens ligt hier voor, 50% er achter.
8. Ideale massa vast leggen (230,8g)
(aangezien deze massa het dichtste ligt bij de voorkeur van de grootste groep mensen ligt. (Hierbij wordt niemand uitgesloten, aangezien het hier niet gaat om een massa die mogelijks niet kan worden opgetild.) Met deze waarde werd verder gewerkt in de volgende stap.)

1b Doel: bepalen van het maximaal moment dat op de arm werkt.

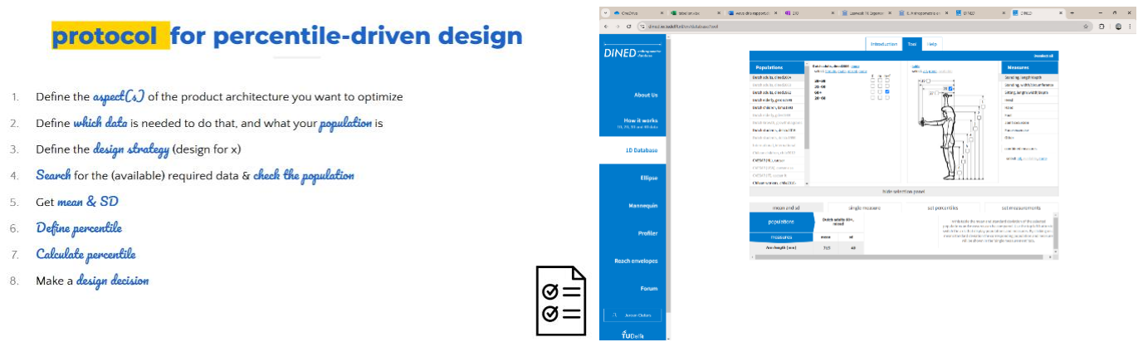
[picture p74: figure]

1. Aspect(s): Het maximaal mogelijk moment werd berekend, om te zien of dit waardes overschrijdt gebaseerd op de voorgaand berekende “ideale massa”:
2. Hiervoor werd gekeken naar de maximale lengte van een gestrekte arm 60+ (afstand van schouder tot te midden het hand).
3. Design stategy: “Design for all” is hierbij de design strategie. Aangezien hiebij willen dat iedereen deze massa comfortabel kan hanteren.
4. Source relevant data: https://dined.io.tudelft.nl/en/reach-envelopes/introduction (https://dined.io.tudelft.nl/en/reach-envelopes/introduction)
5. Data voor 60+ers :
- Mean: 715 mm
- SD: 49 mm

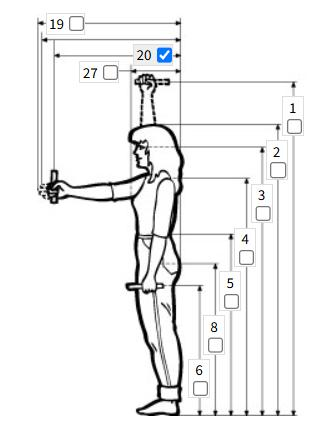
[picture p75: figure]

### 6. Define percentile:

- 99.7% (3*SD)
7. berekening:
- M = F*a
- M= 9.81*0.2308 kg *(( 3* 0.049) +0.715) m
- M= 1,951695576 Nm

### 8. Design beslissing

- Dit maximaal berekend moment werd vergeleken met behulp van chat gpt, en hieruit werd bepaald dat deze belasting vrij klein is. Aangezien het hier gaat over een uiterste waarde, en zelfs deze als klein kan wordt beschouwd, worden de cilinders 230,8 g (indien mogelijk).

2a Deel omtrek cilinder

1. Aspect: Bepalen diameter cilinder a.d.h.v. database
2. Data: Omtrek hand persoon/ grip circumference.
In het ideale geval wordt de data van 60+’ers gebruikt aangezien hierbinnen de doelgroep valt. De data is echter enkel beschikbaar van 20-30 jarigen. Hierdoor wordt met deze data verder gerekend.
3. Design strategy: Design for the mean. Inclusive design minder relevant aangezien “ideale” massa niet volledig uit sluit. Het maximale gewicht ligt dat een mens kan optillen licht hier normaal ver boven.
4. Relevante data: https://dined.io.tudelft.nl/en/reach-envelopes/introduction Database tudelft (referentie theorie gebruiksgericht)

### 5. Get mean and SD:

Gemiddelde: 129mm en SD 13

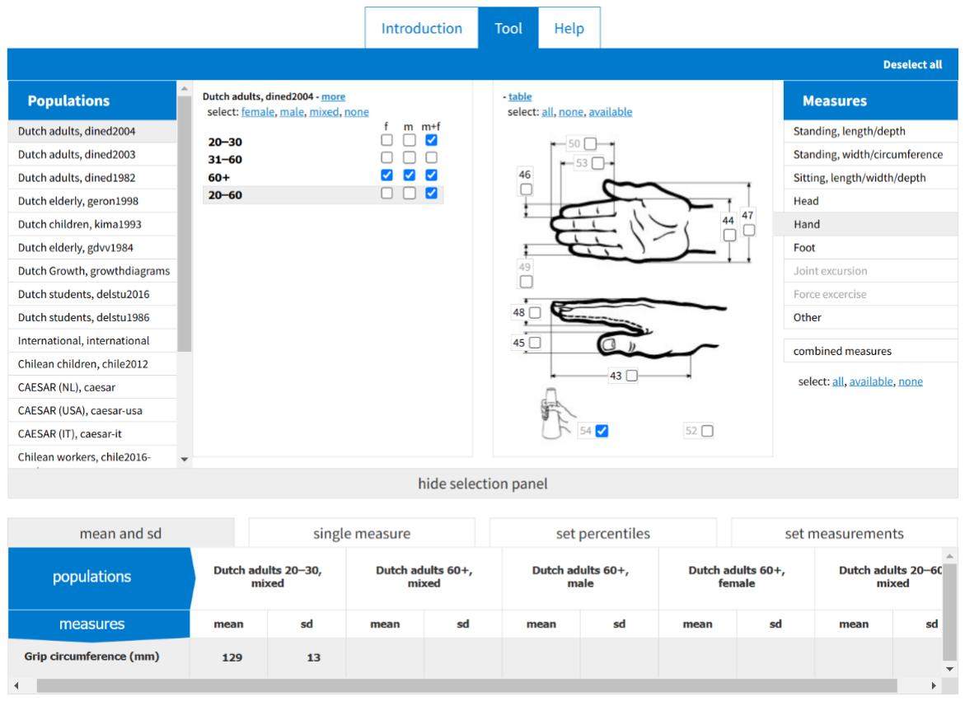
[picture p76: figure]

6. Define: Aangezien design for the mean wordt toegepast wordt rond het gemiddelde en binnen –1SD tot +1SD gekeken. Hierbinnen ligt 68,3% van de gegevens. Deze gemiddelde waarde bedraagt 129mm
7. Calculte: Uit zes volgt dat de omtrek 129mm is. Om hieruit de diameter te berkenen wordt de formule voor de omtrek van een cirkel gebruikt. Omtrek = 2πr = πd . Daarbij staat r voor de straal en d voor de diameter. Hieruit volgt dat de diameter gelijk is aan: diameter =

omtrek
π

=

129
π

= 41,06mm.
8. Design disisions: Deze studie toont aan dat de berekende waarde uit de database en de voorkeursdiameter (45mm) gekozen door de doelgroep dicht aansluit bij de waarde uit de database.

Een belangrijke kritische reflectie hierbij is dat deze gelijkaardige waarden nog steeds op een toeval kunnen wijzen. Dit doordat de maximale omsloten waarde uit de database niet volledig hetzelfde is als de door de gebruiker gekozen diameter.

2b Deel hoogte cilinder adhv database

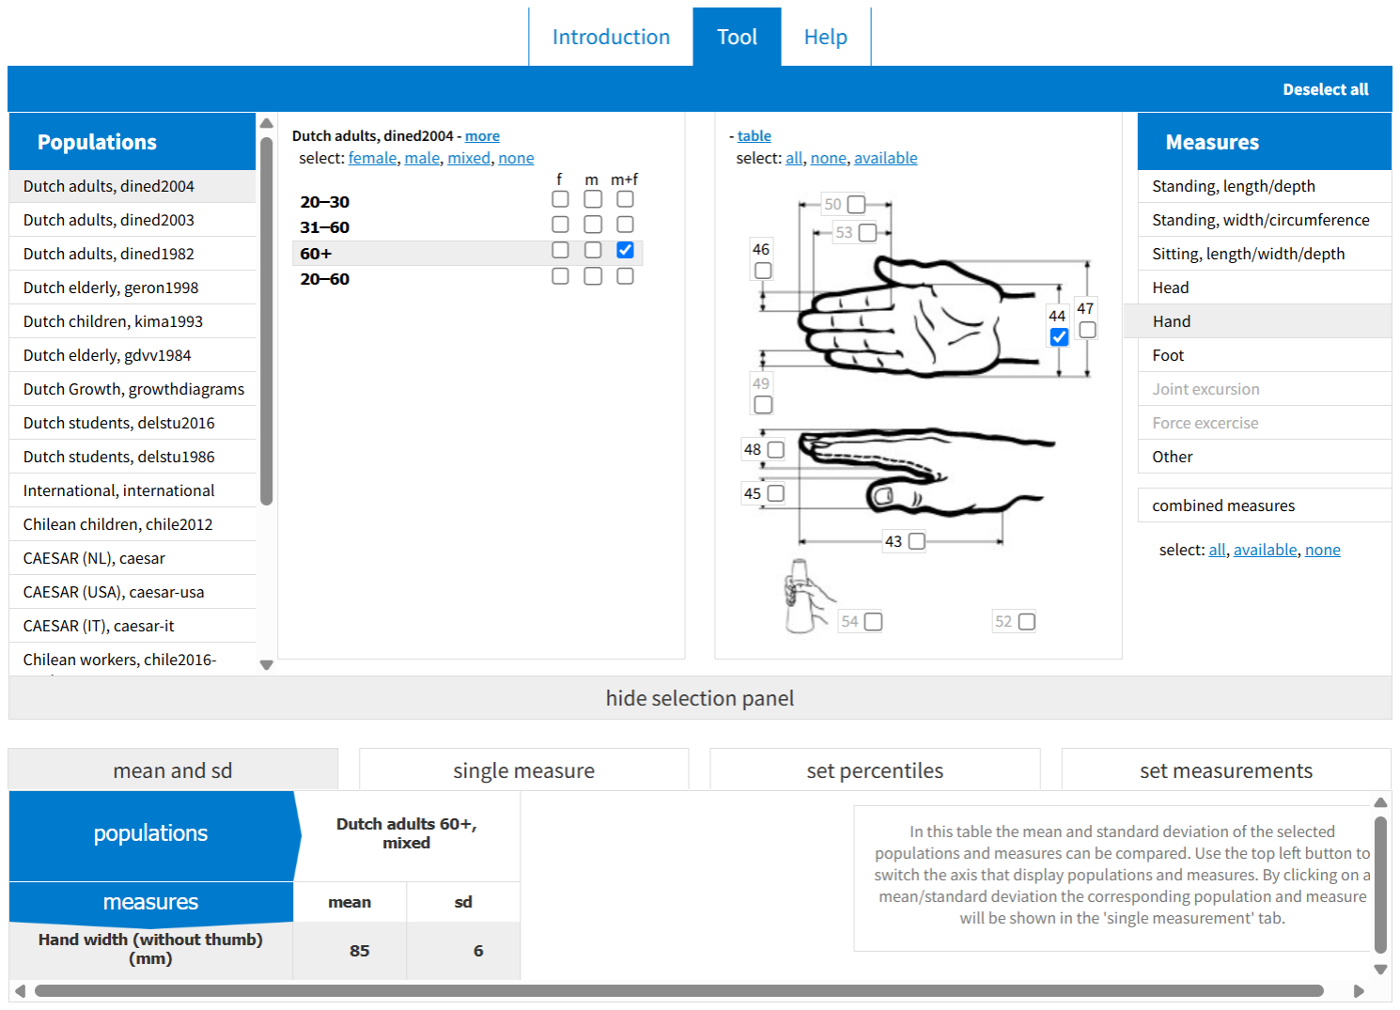
[picture p77: figure]

Het grootste hand moet ook nog kunnen volledig vastnemen dus +3SD: 103mm
1. Aspect
- Bepalen hoogte cilinder a.d.h.v. database

2. Data
- Hoogte van het hand van onder tot boven.
- Aangezien de cilinders (ook) moeten toelaten zijwaarts vastgenomen te worden, en dus voldoende hoog moeten zijn.
3. Design strategy
- “Design for all”
4. Relevante data
- https://dined.io.tudelft.nl/en/reach-envelopes/introduction

### 5. Get mean and SD

- Mean: 85mm
- SD: 6mm

### 6. Define

- Design for all => zelf het grootste hand moet er volledig omheen passen, dus we tellen de SD 3 keer op bij de mean
- Mean+3*SD

### 7. Calculate

- Mean+3*SD
- 85 + 3*6 = 103mm

### 8. Design disisions

- De hoogte van de cilinders moet 103mm zijn
