Thoma-D/UCD/Definition.Jeroen.Thoma.pdf

# Concept title

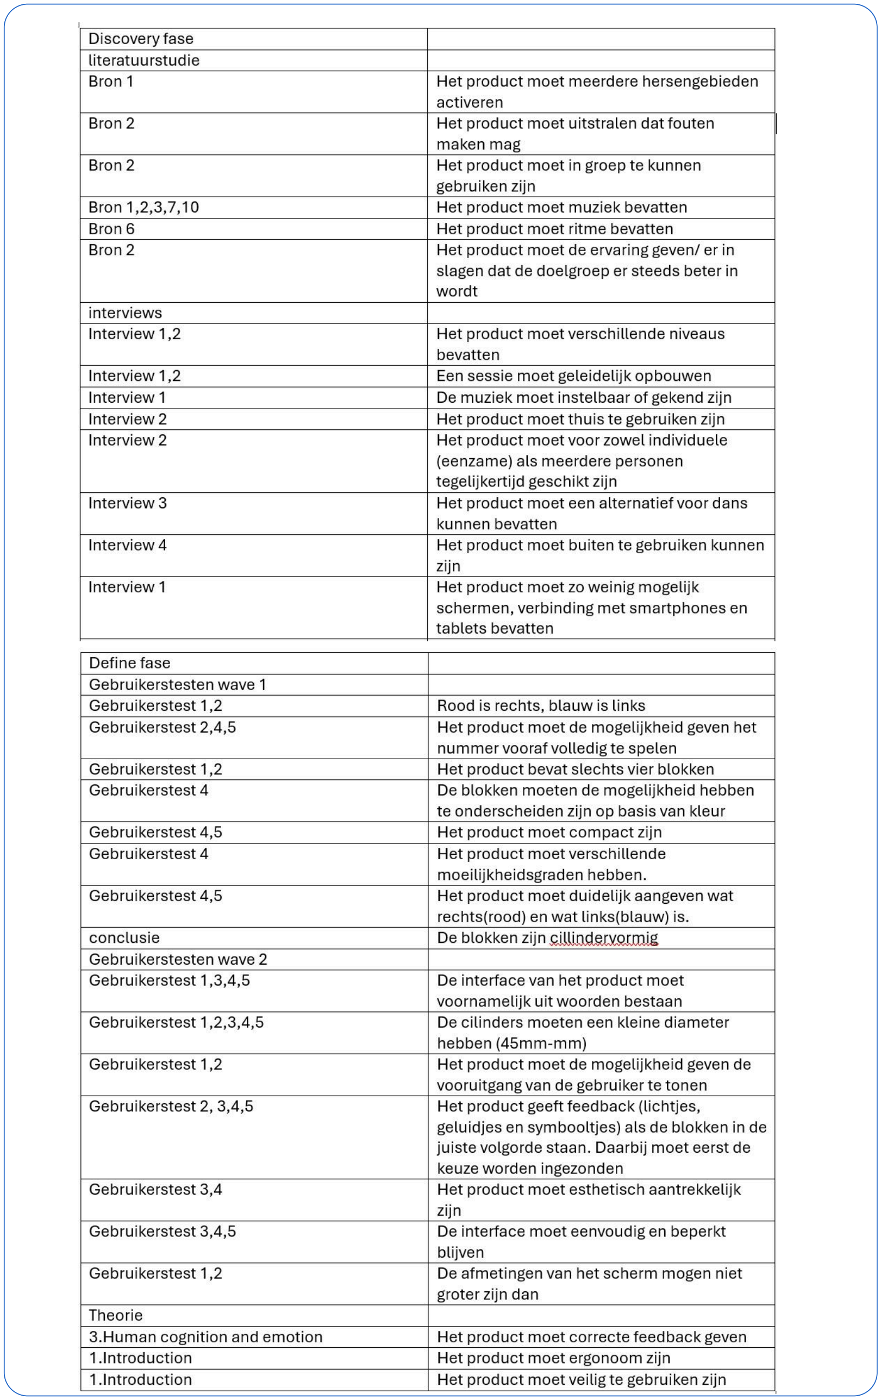
[picture p118: figure]

# Storyboard

# Concept sketch

Prototype & test cycle 1 | Overview of design requirements

# What is your current working title?

# Link to your storyboard

# Drop your hero sketches below

# Overview of the first iteration

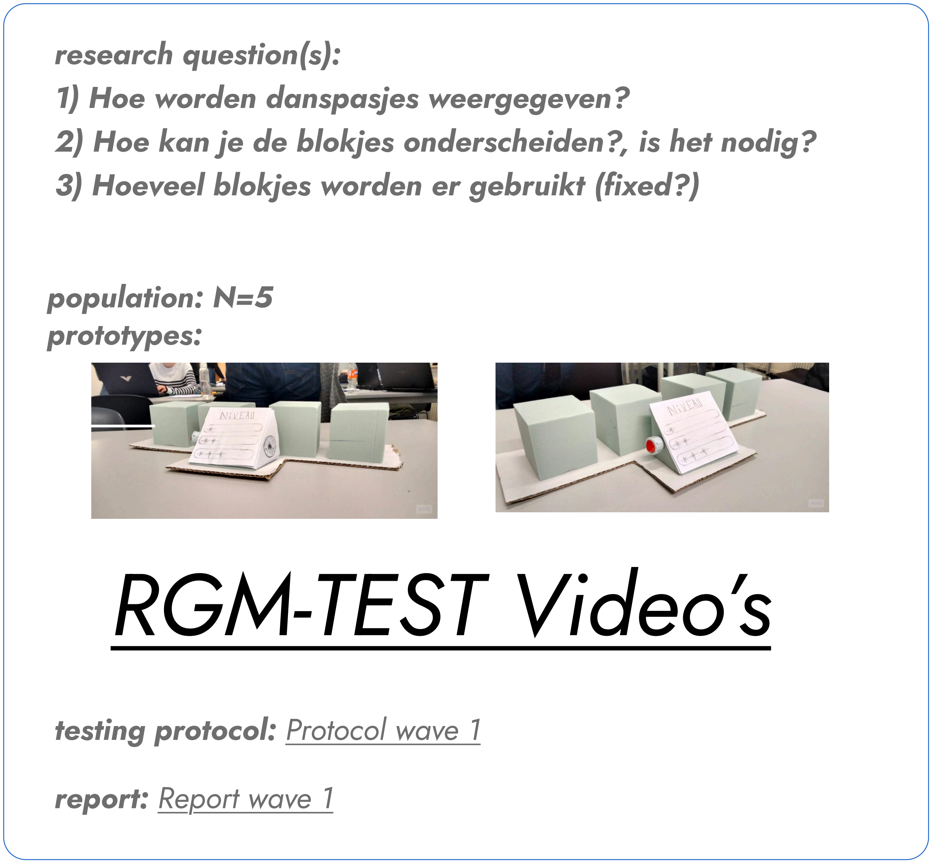
[picture p119: figure]
research question(s):; 1) Hoe worden danspasjes weergegeven?; population: N=5; prototypes:; testing protocol: Protocol wave 1; report: Report wave 1; RGM-TEST Video s

# 2) Hoe kan je de blokjes onderscheiden?, is het nodig?

# 3) Hoeveel blokjes worden er gebruikt (fixed?)

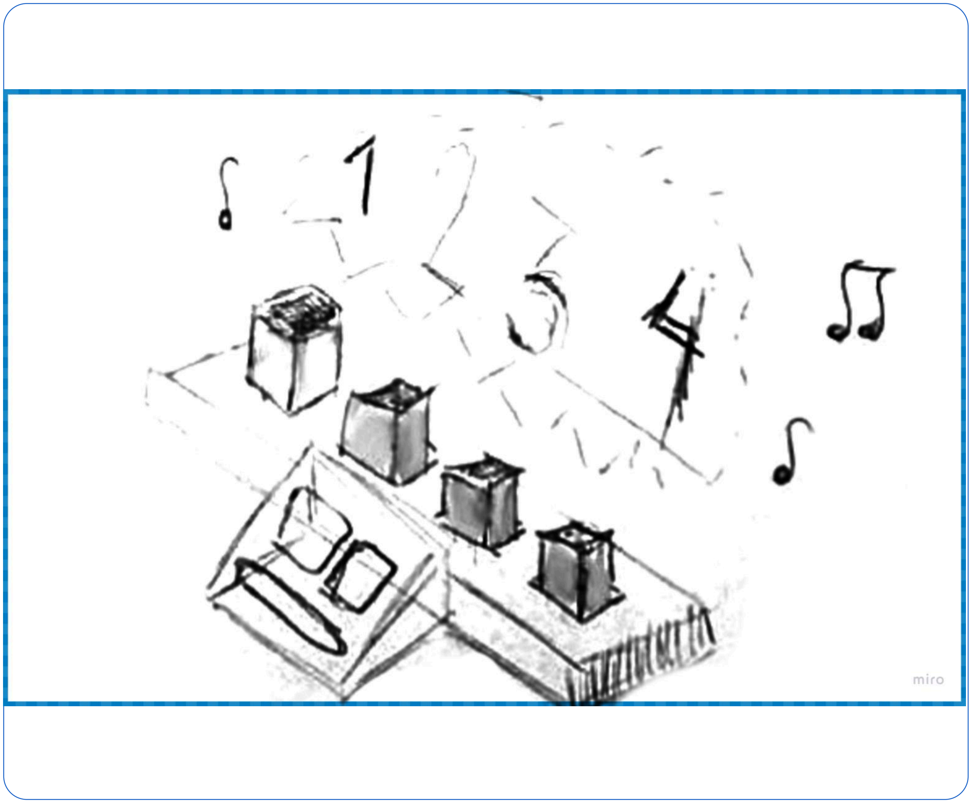
[picture p120: figure]

# key insights & design decisions:

# Prototype & test cycle 2

# Overview of the second iteration

# research question(s):

# 1)Welke displaygrootte moet het product hebben?

# 2)Kent de doelgroep beloningssystemen en staan ze hiervoor open?

# 3)Is de interface eenvoudig genoeg voor de doelgroep?

# key insights & design decisions:

# population: N=5

# prototypes:

testing protocol: Protocol wave 2 (https://ugentbe-my.sharepoint.com/:w:/g/personal/jeroen_cieters_ugent_be/EVlg-_UsiX5MjOUEbipSutcBZTBByyWlfQVrhqUptC4-CQ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)

report: Report wave 2 (https://ugentbe-my.sharepoint.com/:w:/g/personal/jeroen_cieters_ugent_be/EYQjEulQ_jNArWXXt51aB7YB0985nQQIuzc9Lj53KZ-pAA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)

# TEMPLATE DEFINITION ASSIGNMENT

# Interative blocks RGM toegepast in een ander innovatief jasje

Storyboard, on Miro (https://miro.com/welcomeonboard/Q29QSVdDT2ZqMmE5VUxPVllGT1RpN3cvKzBGcWpHbms1SiswMUp4Wk9aMjFxK3oxRGk4eGF6ZnpEYVRhRlE1WXZJajBSTTBOZkpXeDhscjB1d0t6NjdYaXF3T1JYUU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)

## Klantbehoeften

## 1,3,4,5 De interface van het product moet voornamelijk uit woorden bestaan

## 1,2,3,4,5 De cilinders moeten een kleine diameter hebben (45mm-mm)

1,2 Het product moet de mogelijkheid geven de vooruitgang van de gebruiker te tonen,
2, 3,4,5 Het product geeft feedback (lichtjes, geluidjes en symbooltjes) als de blokken in de juiste volgorde staan.

## Daarbij moet eerst de keuze worden ingezonden. (1)

3,4: Het product moet esthetisch aantrekkelijk zijn.

## 3,4,5 De interface moet eenvoudig en beperkt blijven (2)

## 1,2 De afmetingen van het scherm mogen niet groter zijn dan(3)

## Test1,2: Rood is rechts, blauw is links

Test2,4,5: Het product moet de mogelijkheid geven het nummer vooraf volledig te spelen.

## Test1,2: Het product bevat slechts vier blokken

## Test 4: heeft graag verschillende kleuren van doosjes

Test 4,5: Het product moet compact zijn.

Test 4: Het product moet verschillende moeilijkheidsgraden hebben.
Test 4 en 5: Het product moet duidelijk aangeven wat rechts(rood) en wat links(blauw) is.

## Conclusie: De blokken hebben de vorm van een cillinder

De gebruiker blijft gemotiveerd en staat open om het product te (blijven) gebruiken. Enkel de blokken in de juiste volgorde te plaatsen. Bijgevolg is het gebruik van slechts vier blokken

aangeraden. En moet het mogelijk zijn het nummer op voorhand te beluisteren. Dit op expliciete vraag van de gebruiker en om het in de juiste volgorde te plaatsen vereenvoudigen. In

elk interview gaf de gebruiker aan dat deze het lied graag op voorhand zou beluisteren. De testen geven een verdeeld antwoord op de vraag of het nodig is de blokken van elkaar te

kunnen onderscheiden. Om alle testers tevreden te stemmen zal de gebruiker de mogelijkheid krijgen. De onderkanten zijn allemaal zwart, de bovenkant in een kleur. Uit interview 4 en

5 bleek dat zij moeilijkheden hadden met het linken van de kleur aan de richting. Om dit te verhelpen zal langs beide uiteinden van het docking station rood of blauw voorzien worden.

Bij de meeste gebruikers ging het voorkeur uit naar een kleinere variant. Dit omdat deze makkelijker op te bergen zijn. Ze vinden deze beter in de hand zitten.

Interface 1 (https://www.figma.com/design/PEY1bDh1OrohykHiABHBeu/Untitled?node-id=0-1&m=dev&t=NbRUxabWHmzq1Nho-1) Interface 2 (https://www.figma.com/design/OPnF0q4fp7Sg4oOebe9XTc/RGM-Interface?node-id=0-1&m=dev&t=hBAkDXgNw6biDhxd-1)

# Github link (https://github.com/Thoma-D/UCD.git)
