Thoma-D/UCD/Bijlages/Discovery/protocol literatuurstudie.pdf

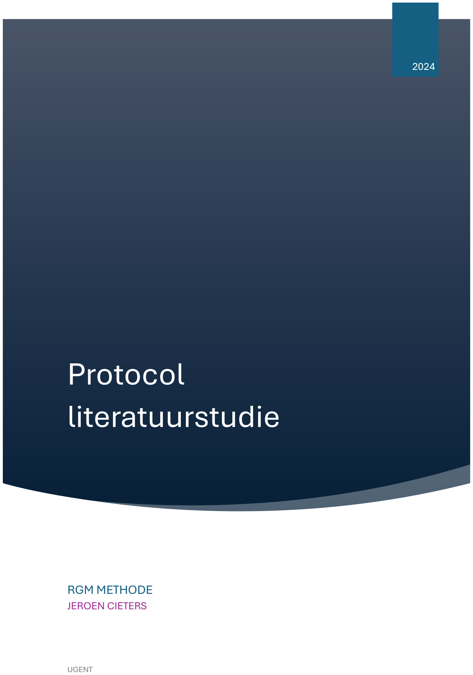
[picture p162: page 1]

# Protocol literatuurstudie

2024

### RGM METHODE

JEROEN CIETERS

UGENT

### Protocol voor de literatuurstudie aan de hand van deskresearch

Oriëntatie in ontwerpproces: “discovery” fase Methode: desk research
Onderzoeksvraag primair:
- Wat is de RGM methode?
Onderzoeksvragen secundair:
- Hoe helpt de RGM methode mensen?
- Hoe werkt deze methode?
- voor wie is deze methode het meest geschikt?
- is de doelgroep groot?
- Welke rol speelt muziek?
- Hoe werkt dit in de hersenen?
Doel:
- Een breed beeld krijgen in de case en van het probleem.
- antwoord krijgen op de onderzoeksvragen,
- Het probleem afbakenen
- Innovatrix en fishbone opstellen
- De gebruiker duidelijk definiëren
- Opstellen klantbehoeften
Soort bronnen:
Het is belangrijk een volledig beeld te krijgen in dit topic. Hierdoor is het belangrijk naast wetenschappelijke artikels ook eens verder te kijken en gebruik te maken van databases, gewone artikels en websites. Om voldoende ingelezen te zijn worden 10 bronnen gebruikt. Aanpak:
1. Controleren objectiviteit
2. Samenvatten
3. Terugkoppelen naar onderzoeksvraag
4. Verwerken: Conclusies trekken, opstellen klantbehoeften en opstellen templates

Data:

26/09/24 | Les
28/09/24 | Keuze onderwerp
3/10/24 | Les
5/10/24 | Opstellen protocol literatuurstudie
6/10/24 | Uitvoeren literatuurstudie
10/10/24 | Les
12/10/24 | Uitvoeren literatuurstudie
13/10/24 | Uitvoeren literatuurstudie
18/10/24 | Sprint day
22/10/24 | Afwerken literatuurstudie
27/10/24 | Afwerken literatuurstudie
