Thoma-D/UCD/afbeeldingen/DEV2_optstelling.jpg

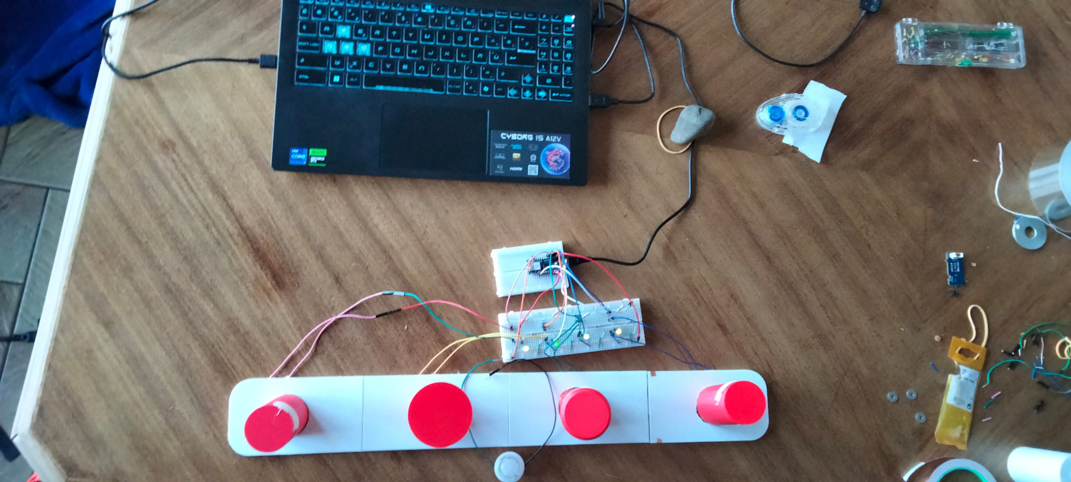
afbeeldingen/DEV2_optstelling.jpg
