Thoma-D/UCD/afbeeldingen/DEV3_ solo.png

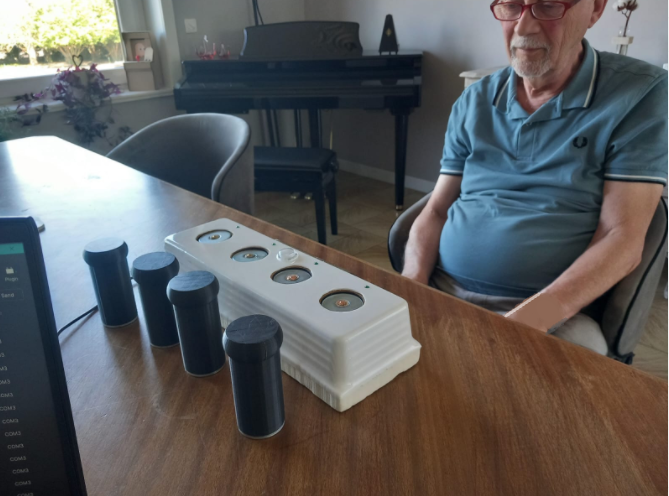
afbeeldingen/DEV3_ solo.png
