Thoma-D/UCD/afbeeldingen/Gebruikerstest_Dev2_Estetiek.jpg

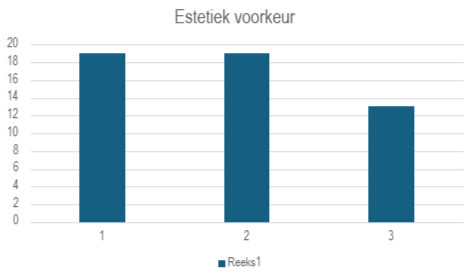
afbeeldingen/Gebruikerstest_Dev2_Estetiek.jpg
