Thoma-D/UCD/afbeeldingen/moodboard.png

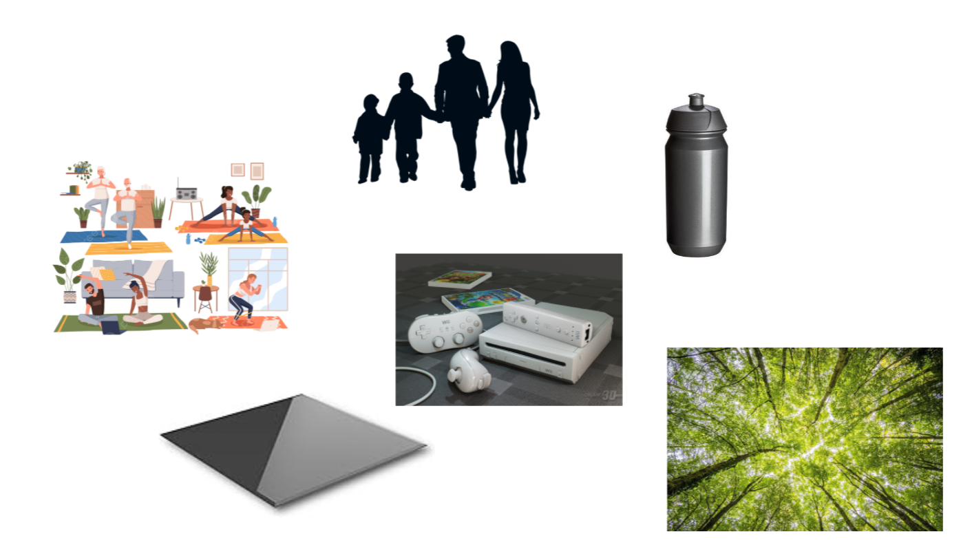
afbeeldingen/moodboard.png
