Thoma-D/UCD/afbeeldingen/Prototype 1 (1).jpg

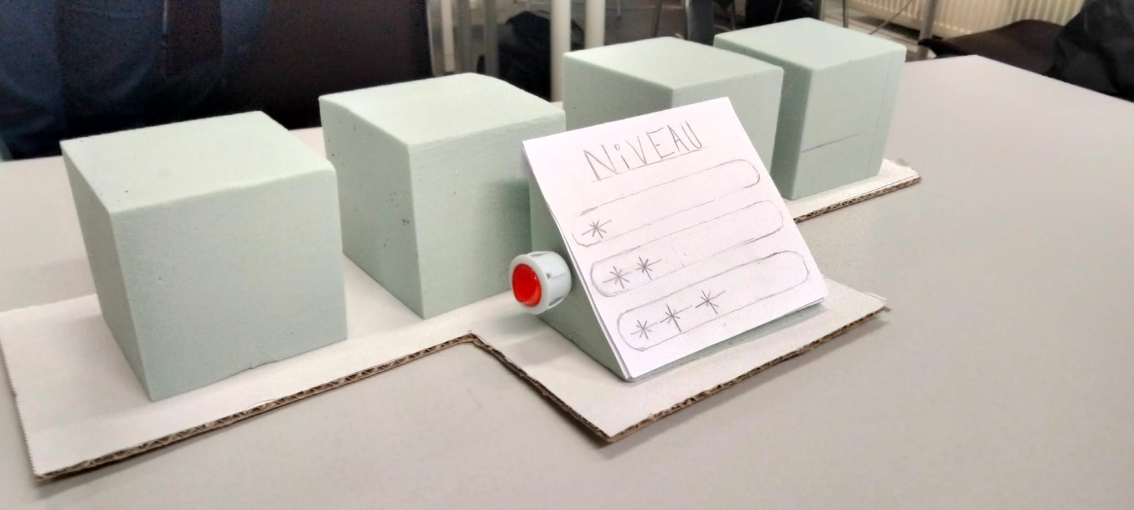
afbeeldingen/Prototype 1 (1).jpg
