Thoma-D/UCD/afbeeldingen/render_eind.png

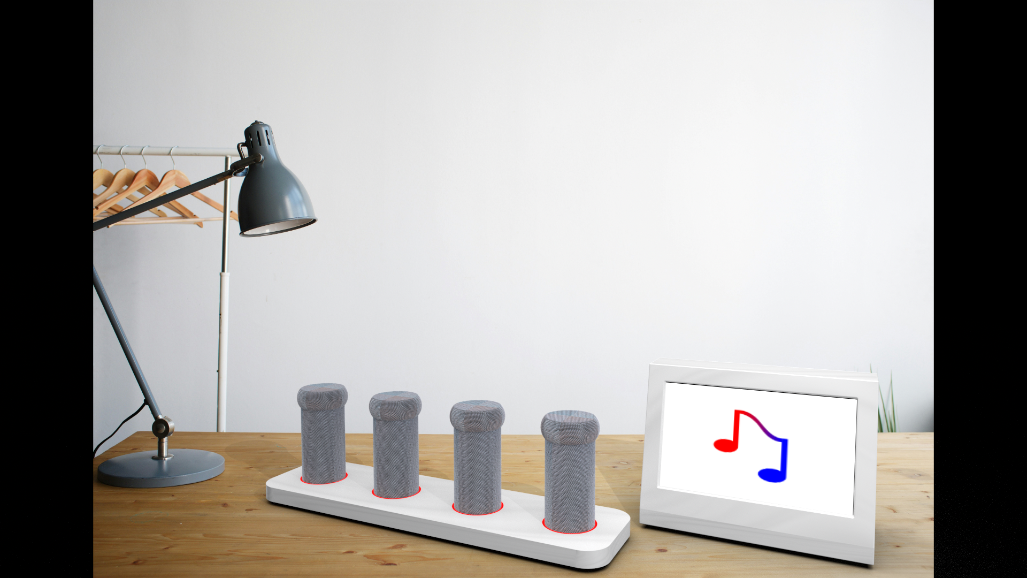
afbeeldingen/render_eind.png
