Thoma-D/UCD/afbeeldingen/volgorde cilinder.png

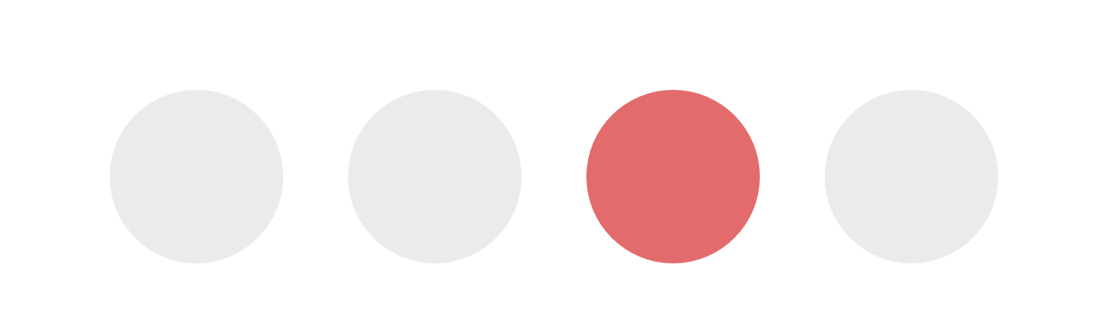
afbeeldingen/volgorde cilinder.png
