Thoma-D/UCD/(list of files, cad)

Other CAD files:
CAD files/finale bestanden/cilinder/cilinder+plaatsRondellen.prt
CAD files/finale bestanden/cilinder/dop2.prt
CAD files/finale bestanden/docking/assembly1.prt
CAD files/finale bestanden/docking/matrijs1A.prt
CAD files/finale bestanden/docking/matrijs2A.prt
CAD files/finale bestanden/docking/plaat1A.prt
CAD files/finale bestanden/docking/plaat2A.prt
CAD files/prototypes/CAD render/assembly1.prt
CAD files/prototypes/CAD render/cilinder.prt
CAD files/prototypes/CAD render/docking.prt
CAD files/prototypes/CAD render/dockingscherm.prt
CAD files/prototypes/CAD render/dop2.prt
CAD files/prototypes/Dockingstation/Bovenkant A.prt
CAD files/prototypes/Dockingstation/Bovenkant B.prt
CAD files/prototypes/Dockingstation/Bovenkant C.prt
CAD files/prototypes/Dockingstation/ONDERKANT B.prt
CAD files/prototypes/Dockingstation/ONderkant C.prt
CAD files/prototypes/Dockingstation/Onderkant A.prt
CAD files/prototypes/cilinders/cilinder.prt
CAD files/prototypes/cilinders/dop1.prt
CAD files/prototypes/cilinders/dop2.prt
CAD files/prototypes/cilinders/dop3.prt
