Thoma-D/UCD/Bijlages/Discovery/ProtocoL_Benchmarking_Thoma_Demets.pdf

*Vul hier de datum in* | Benchmark Studie

# Protocol

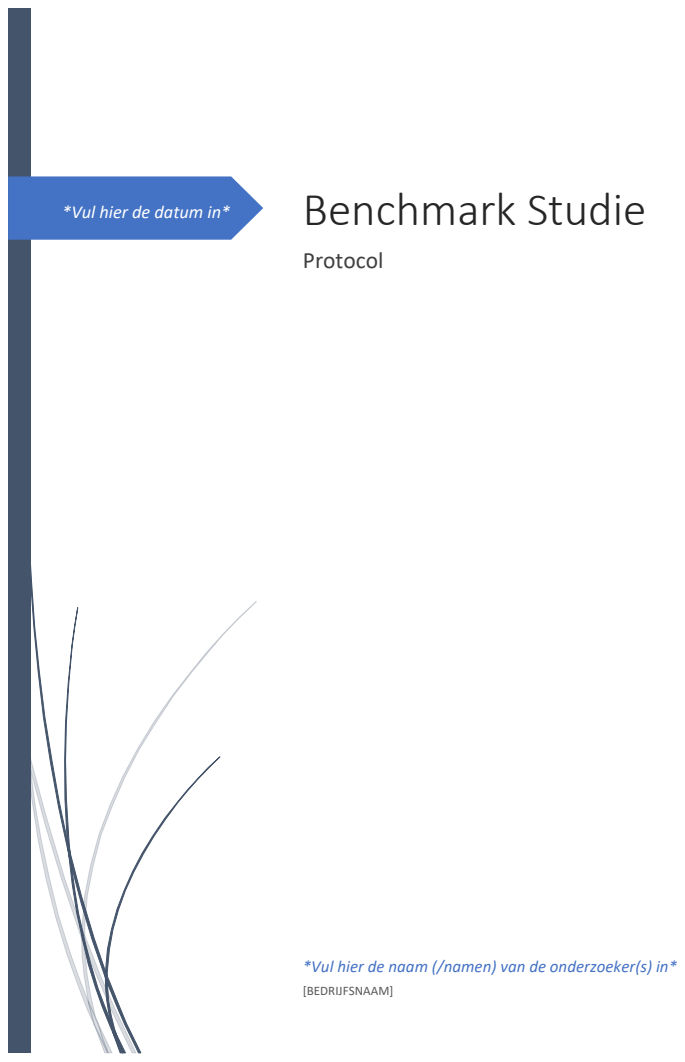
[picture p170: page 1]
[BEDRIJFSNAAM]

*Vul hier de naam (/namen) van de onderzoeker(s) in*

*VUL HIER DE TITEL VAN HET ONDERZOEK IN*

ONDERZOEKSVRAAG:

*Vul hier de Onderzoeksvraag(en) in*

DOEL VAN HET ONDERZOEK

*Vul hier de nodig info in I.v.m. het doel van het onderzoek*

ONDERZOEKSTEAM

*Vul hier de naam/namen van de onderzoekers in, en vermeld daarbij hun rollen/ taken doorheen het onderzoek*

Recruitment van participanten

*Niet van toepassing*

MATERIALEN

- *Vul hier in op welke manier je aan je informatie bent gekomen, welke templates hierbij werden gebruikt*

STAP-VOOR-STAP BESCHRIJVING

1. Productselectie: * Selecteer 11 producten die relevant zijn met de onderzoeksvraag*
2. Data-verzameling: *Doe research over de 11 producten, noteer alle relevante info in a.d.h.v. volgende template*
Product | Omschrijving | Analyse | Requirements en Specificaties | Fysieke en Vormgevingsaspecten | Bron
… | … | … | … | … | …
3. Data-analyse:*Vergelijk onderling de producten, ga opzoek naar interessante patronen, vormen, en designkeuzes die daar zijn gemaakt, link dit ook terug naar de onderzoeksvraag*
4. Conclusie/Uitkomstverwijzing: *Vat de belangrijkste en meeste relevante realisaties samen in een laatste besluit*

Dataverzamelingsmethode

- *Vul hier in op welke manier je aan je informatie bent gekomen*

Informed consent

*Niet van toepassing*

PILOT TEST

*Niet van toepassing*
